gvayoy-web/proyecto-domus/hardware/Conexion_Domus_Guia_Completa.html

# DOMUS v5 - Guia de Conexiones Completa

Para la feria de ciencias - Todo paso a paso, sin experiencia previa requerida

## 1. COMPONENTES NECESARIOS

Tenemos: 2 protoboards, 1 fuente 5V/2A, ESP32-S3 N16R8, cables, componentes listados en nota 74.

# | Componente | Cantidad | Para que sirve | Protoboard

1 | ESP32-S3 N16R8 | 1 | Cerebro del sistema | Protoboard 1 (logica)
2 | LCD1602 + I2C backpack | 1 | Pantalla 16x2 caracteres | Protoboard 1
3 | DFPlayer Mini | 1 | Reproductor MP3 (voz Jarvis) | Protoboard 2 (cargas)
4 | Parlante 4ohm 3W | 1 | Audio principal | Protoboard 2
5 | Parlante 8ohm 1W | 1 | Audio serie (opcional) | Protoboard 2
6 | VS1838B receptor IR | 1 | Recibe mando remoto | Protoboard 1
7 | Mando IR 21 teclas | 1 | Control remoto | Mano del usuario
8 | DHT11 | 1 | Temperatura y humedad aire | Protoboard 1
9 | Sensor suelo resistivo | 1 | Humedad de la tierra | Protoboard 2
10 | Sensor nivel agua | 1 | Nivel del deposito | Protoboard 2
11 | LDR | 1 | Sensor de luz ambiental | Protoboard 1
12 | Mini bomba DC 3-6V | 1 | Riego automatico | Protoboard 2
13 | S8050 transistor NPN | 2 | Switch para bomba y LED VIVO | Protoboard 2 / 1
14 | LED sala + LED ducha | 2 | Luces de casa (paralelo) | Protoboard 2
15 | LED porche | 1 | luz exterior | Protoboard 2
16 | LED cultivo (x3) | 3 | Luces de invernadero | Protoboard 2
17 | LED VIVO azul | 1 | Indicador breathing | Protoboard 1
18 | Boton PARO | 1 | Emergencia fisica | Protoboard 1
19 | 1N4007 diodo | 1 | Proteccion bomba (flyback) | Protoboard 2
20 | Fuente 5V/2A USB-C | 1 | Alimenta bomba + LEDs + DFPlayer | Protoboard 2
21 | microSD 4-32GB | 1 | Almacena audios Jarvis | Dentro del DFPlayer

## 2. RESISTENCIAS NECESARIAS

Valor | Cantidad | Para que | Donde
330 ohm | 2 | Limitar corriente LED sala+ducha y LED porche | Protoboard 2
100 ohm | 1 | Limitar corriente 3xLED cultivo paralelo | Protoboard 2
1k ohm | 2 | Base S8050 (bomba + LED VIVO) | Protoboard 2 y 1
10k ohm | 3 | Pull-up DHT11, divisor LDR, bias S8050 | Protoboard 1

## 3. DISTRIBUCION EN PROTOBOARDS

GND COMUN: Ambos protoboards deben estar conectados por un cable GND. La tierra es la misma para todo.

PROTOBOARD 1 - LOGICA (alimentada por USB del ESP32)

Aqui van todos los componentes de señal y logica. Se alimentan del USB del ESP32 (3.3V y 5V del pin).

- ESP32-S3 - El cerebro, montado aqui
- LCD1602 I2C - SDA→GPIO17, SCL→GPIO13
- VS1838B IR - DATA→GPIO12
- DHT11 - DATA→GPIO14 + pull-up 10k
- LDR - Señal→GPIO3 + divisor 10k
- LED VIVO azul - Via S8050 → GPIO9
- Boton PARO - → GPIO10 → GND

PROTOBOARD 2 - CARGAS (alimentada por 5V/2A)

Aqui van todos los actuadores que consumen corriente. Se alimentan de la fuente externa 5V/2A.

- Bomba DC - Via S8050 → GPIO4 (senal desde Proto 1)
- LED sala + ducha - Paralelo → GPIO5 (senal)
- LED porche - → GPIO8 (senal)
- 3xLED cultivo - Paralelo → GPIO7 (senal)
- DFPlayer Mini - RX→GPIO11, TX→GPIO18 (senal)
- Sensor suelo - AO→GPIO15 (senal)
- Sensor nivel - S→GPIO16 (senal)

Los cables de senal (GPIO) van del Proto 2 al Proto 1. Usa cables largos de colores para no perderlos. Cada cable GPIO necesita un cable GND comun.

## 4. MAPA GPIO DEFINITIVO

GPIO | Funcion | Componente | Tipo | Protoboard | Color cable
3 | LDR | Fotoresistor + divisor 10k | Entrada analogica | 1 | Morado
4 | Bomba | S8050 base → colector bomba | Salida | 2 | Rojo
5 | Casa | 2 LEDs paralelo + 330ohm | Salida | 2 | Amarillo
7 | Cultivo | 3 LEDs paralelo + 100ohm | Salida | 2 | Azul
8 | Porche | 1 LED + 330ohm | Salida | 2 | Verde
9 | Jarvis VIVO | LED azul via S8050 | Salida PWM | 1 | Blanco
10 | PARO | Boton → GND | Entrada Pull-up | 1 | Gris
11 | ESP32 TX→DFPlayer RX | ESP32 envia comandos al DFPlayer | Salida | 2 | Naranja
12 | IR | VS1838B DATA | Entrada | 1 | Amarillo oscuro
13 | LCD SCL | I2C clock | Bidireccional | 1 | Azul claro
14 | DHT11 | DATA + pull-up 10k | Entrada | 1 | Naranja
15 | Suelo | Sensor resistivo AO | Entrada analogica | 2 | Marron
16 | Nivel | Sensor analogico S | Entrada analogica | 2 | Gris oscuro
17 | LCD SDA | I2C data | Bidireccional | 1 | Verde
18 | ESP32 RX←DFPlayer TX | ESP32 recibe datos del DFPlayer | Entrada | 2 | Morado

## 5. DIAGRAMA DE CONEXIONES

### Protoboard 1 - Logica

┌─────────────────────────────────────────────────────────────────────┐ │ PROTOBOARD 1 - LOGICA │ │ (Alimentada por USB ESP32) │ │ │ │ ┌──────────────────────────────────────────┐ │ │ │ ESP32-S3 N16R8 │ │ │ │ │ │ │ │ GPIO3 ──────── LDR (via 10k divider) │←── SEÑAL │ │ │ GPIO4 ──────── → Proto 2 (bomba) │←── SEÑAL │ │ │ GPIO5 ──────── → Proto 2 (casa LEDs) │←── SEÑAL │ │ │ GPIO7 ──────── → Proto 2 (cultivo) │←── SEÑAL │ │ │ GPIO8 ──────── → Proto 2 (porche) │←── SEÑAL │ │ │ GPIO9 ──────── LED VIVO (S8050) │←── SEÑAL │ │ │ GPIO10 ──────── Botón PARO → GND │←── GND │ │ │ GPIO11 ──────── RX ← DFPlayer TX │←── SEÑAL │ │ │ GPIO12 ──────── VS1838B DATA │←── SEÑAL │ │ │ GPIO13 ──────── LCD SCL │←── SEÑAL │ │ │ GPIO14 ──────── DHT11 DATA + 10k pull │←── SEÑAL │ │ │ GPIO15 ──────── → Proto 2 (suelo AO) │←── SEÑAL │ │ │ GPIO16 ──────── → Proto 2 (nivel S) │←── SEÑAL │ │ │ GPIO17 ──────── LCD SDA │←── SEÑAL │ │ │ GPIO18 ──────── TX → DFPlayer RX │←── SEÑAL │ │ │ │ │ │ │ 3V3 ──────── DHT11 VCC, LCD VCC, pull-ups │ │ │ GND ──────── GND comun (→ Proto 2 GND) │←── GND │ │ └──────────────────────────────────────────┘ │ │ │ │ ┌─────────────────┐ ┌─────────────────┐ ┌─────────────────┐ │ │ │ LCD1602 I2C │ │ VS1838B IR │ │ DHT11 │ │ │ │ SDA→GPIO17 │ │ DATA→GPIO12 │ │ DATA→GPIO14 │ │ │ │ SCL→GPIO13 │ │ VCC→3V3 │ │ VCC→3V3 │ │ │ │ VCC→5V (USB) │ │ GND→GND │ │ GND→GND │ │ │ │ GND→GND │ └─────────────────┘ └─────────────────┘ │ │ └─────────────────┘ │ │ ┌─────────────────┐ ┌─────────────────┐ │ │ │ LDR + 10k │ │ Botón PARO │ │ │ │ 1 terminal→3V3 │ │ 1 pin→GPIO10 │ │ │ │ 1 terminal→GPIO3│ │ 1 pin→GND │ │ │ │ 1 terminal→GND │ │ (usa INPUT_PULLUP)│ │ │ └─────────────────┘ └─────────────────┘ │ │ │ │ ┌─────────────────────────────────────────┐ │ │ │ LED VIVO azul + S8050 │ │ │ │ Base → 1k → GPIO9 │ │ │ │ Colector → LED → 330ohm → 5V (USB) │ │ │ │ Emisor → GND │ │ │ └─────────────────────────────────────────┘ │ │ │ │ ═══════════════════════════════════════════════════════════════ │ │ CABLE GND GRUESO → Proto 2 GND (OBLIGATORIO) │ │ CABLES GPIO × 8 → Proto 2 (señales de control) │ └─────────────────────────────────────────────────────────────────────┘

### Protoboard 2 - Cargas

┌─────────────────────────────────────────────────────────────────────┐ │ PROTOBOARD 2 - CARGAS │ │ (Alimentada por Fuente 5V/2A) │ │ │ │ ═══ 5V/2A ═══ ═══ GND ═══ │ │ │ │ ┌─────────────────────────────────────────┐ │ │ │ BOMBA DC 3-6V + S8050 + 1N4007 │ │ │ │ │ │ │ │ GPIO4(Proto1) → 1k → Base S8050 │←── SEÑAL GPIO4 │ │ │ Emisor S8050 → GND │ │ │ │ Colector S8050 → Bomba (-) │ │ │ │ Bomba (+) → 5V/2A │ │ │ │ 1N4007 diodo en paralelo con bomba │ │ │ │ (cátodo→Bomba+, ánodo→Bomba-) │ │ │ └─────────────────────────────────────────┘ │ │ │ │ ┌─────────────────────────────────────────┐ │ │ │ LED SALA + LED DUCHA (paralelo) │ │ │ │ │ │ │ │ GPIO5(Proto1) → 330ohm → (Anodo LED1 │←── SEÑAL GPIO5 │ │ │ + Anodo LED2) │ │ │ │ Cathodo LED1 + Cathodo LED2 → GND │ │ │ └─────────────────────────────────────────┘ │ │ │ │ ┌─────────────────────────────────────────┐ │ │ │ LED PORCHE │ │ │ │ │ │ │ │ GPIO8(Proto1) → 330ohm → Anodo LED │←── SEÑAL GPIO8 │ │ │ Cathodo LED → GND │ │ │ └─────────────────────────────────────────┘ │ │ │ │ ┌─────────────────────────────────────────┐ │ │ │ 3x LED CULTIVO (paralelo) │ │ │ │ │ │ │ │ GPIO7(Proto1) → 100ohm → (Anodo LED1 │←── SEÑAL GPIO7 │ │ │ + Anodo LED2 │ │ │ │ + Anodo LED3) │ │ │ │ Cathodos → GND │ │ │ └─────────────────────────────────────────┘ │ │ │ │ ┌─────────────────────────────────────────┐ │ │ │ DFPLAYER MINI │ │ │ │ │ │ │ │ VCC → 5V/2A │ │ │ │ GND → GND │ │ │ │ RX ← GPIO18(Proto1) TX ← ESP32 envia │←── SEÑAL GPIO18 │ │ │ TX → GPIO11(Proto1) RX → ESP32 recibe │←── SEÑAL GPIO11 │ │ │ BUSY → (opcional, no conectado) │ │ │ │ SPK_1 → Parlante 4ohm → SPK_2 │ │ │ │ ADKEY_1 → (no conectado) │ │ │ └─────────────────────────────────────────┘ │ │ │ │ ┌─────────────────────────────────────────┐ │ │ │ SENSOR SUELO RESISTIVO │ │ │ │ VCC → 5V/2A │ │ │ │ GND → GND │ │ │ │ AO → GPIO15(Proto1) ← SEÑAL │←── SEÑAL GPIO15 │ │ └─────────────────────────────────────────┘ │ │ │ │ ┌─────────────────────────────────────────┐ │ │ │ SENSOR NIVEL AGUA │ │ │ │ VCC → 5V/2A │ │ │ │ GND → GND │ │ │ │ S → GPIO16(Proto1) ← SEÑAL │←── SEÑAL GPIO16 │ │ └─────────────────────────────────────────┘ │ │ │ │ ═══════════════════════════════════════════════════════════════ │ │ CABLE GND GRUESO ← Proto 1 GND (OBLIGATORIO) │ │ CABLES GPIO × 8 ← Proto 1 (señales de control) │ └─────────────────────────────────────────────────────────────────────┘

## 6. PASOS DE CONEXION (sin experiencia)

### Fase 1: Protoboard 1 - Logica (30 minutos)

1 Montar ESP32 en protoboard
Inserta el ESP32-S3 N16R8 en el protoboard, cruzando la ranura central. Los pines del lado izquierdo (GPIO 3-18) son los que usaremos.

2 Conectar LCD1602 I2C
El LCD tiene 4 pines: VCC, GND, SDA, SCL.

Pin LCD | Conectar a | Color
VCC | 5V del ESP32 (pin 5V) | Rojo
GND | GND del ESP32 | Negro
SDA | GPIO17 del ESP32 | Verde
SCL | GPIO13 del ESP32 | Azul

El LCD I2C tiene una resistencia que dice "I2C" o "PCF8574". Asegurate de que el address sea 0x27 (el más común).

ALGUNOS backpacks I2C tienen pull-ups de SDA/SCL hacia 5V. El ESP32-S3 usa logica de 3.3V. Si el backpack tiene pull-ups a 5V, necesitas un divisor de voltaje en SDA y SCL (1k + 2k) para bajar a 3.3V. La mayoria de backpacks baratos funcionan bien directo porque las lineas I2C son open-drain y el voltaje lo define el pull-up.

3 Conectar receptor IR VS1838B
El VS1838B tiene 3 patas: OUT, GND, VCC.

Pin VS1838B | Conectar a | Color
OUT | GPIO12 del ESP32 | Amarillo
GND | GND del ESP32 | Negro
VCC | 3V3 del ESP32 | Rojo

El receptor IR tiene una malla metalica. Apuntalo hacia el mando a 1-2 metros de distancia.

4 Conectar DHT11
El DHT11 tiene 4 patas (mirandolo de frente, de izq a der): VCC, DATA, NC, GND.

Pin DHT11 | Conectar a | Color
VCC (pin 1) | 3V3 del ESP32 | Rojo
DATA (pin 2) | GPIO14 + resistor 10k a 3V3 | Naranja
NC (pin 3) | No conectar | -
GND (pin 4) | GND del ESP32 | Negro

El resistor de pull-up de 10k entre DATA y 3V3 es OBLIGATORIO. Sin él, el DHT11 no responde.

5 Conectar LDR (sensor de luz)
El LDR se conecta en divisor de voltaje:
3V3 ──→ LDR ──→ GPIO3 ──→ 10k ──→ GND

Conexión | Donde
3V3 → 1 terminal del LDR | Protoboard
Otro terminal del LDR → GPIO3 | Protoboard
GPIO3 → resistor 10k → GND | Protoboard

El LDR cambia de resistencia segun la luz. En oscuridad ~100kohm, en luz solar ~1kohm.

6 Conectar LED VIVO (breathing)
LED azul via transistor S8050:
GPIO9 → 1k → Base S8050
Colector S8050 → LED → 330ohm → 5V (USB)
Emisor S8050 → GND

7 Conectar boton PARO
Un pin del boton → GPIO10, otro pin → GND.

El firmware usa INPUT_PULLUP, asi que NO necesitas resistor externo. Solo conecta el boton entre GPIO10 y GND.

8 Conectar cables GPIO al Proto 2
Estos 8 cables van del Proto 1 al Proto 2 (largo ~30-50cm):

GPIO | Para que | Color sugerido
GPIO4 | Bomba (senal) | Rojo
GPIO5 | Casa LEDs (senal) | Amarillo
GPIO7 | Cultivo LEDs (senal) | Azul
GPIO8 | Porche LED (senal) | Verde
GPIO11 | DFPlayer RX (senal) | Naranja
GPIO15 | Sensor suelo (senal) | Marron
GPIO16 | Sensor nivel (senal) | Gris
GPIO18 | DFPlayer TX (senal) | Morado

9 Cable GND comun
CRITICO: Conecta un cable grueso del GND del Proto 1 al GND del Proto 2. Sin esto, nada funciona.

### Fase 2: Protoboard 2 - Cargas (45 minutos)

10 Alimentacion 5V/2A
Conecta la fuente USB-C 5V/2A a las rieles del protoboard: rojo a 5V, negro a GND.

11 Conectar bomba DC + S8050
GPIO4(Proto1) → 1k → Base S8050
Emisor S8050 → GND
Colector S8050 → Bomba(-)
Bomba(+) → 5V/2A
1N4007 diodo: cátodo→Bomba(+), ánodo→Bomba(-)

El diodo 1N4007 es OBLIGATORIO. Sin él, el motor de la bomba puede dañar el transistor al apagarse (fenómeno de retroEMF).

12 Conectar LEDs de casa (sala+ducha)
GPIO5(Proto1) → 330ohm → Anodo LED sala + Anodo LED ducha
Cathodo LED sala + Cathodo LED ducha → GND
Los dos LEDs van en paralelo, compartiendo la misma resistencia.

13 Conectar LED porche
GPIO8(Proto1) → 330ohm → Anodo LED porche
Cathodo LED porche → GND

14 Conectar 3x LED cultivo
GPIO7(Proto1) → 100ohm → (Anodo LED1 + Anodo LED2 + Anodo LED3)
Cathodo LED1 + Cathodo LED2 + Cathodo LED3 → GND
Los 3 LEDs van en paralelo. La resistencia es menor (100ohm) porque hay 3 LEDs compartiendo.

15 Conectar DFPlayer Mini

Pin DFPlayer | Conectar a | Color
VCC | 5V/2A | Rojo
GND | GND | Negro
RX | GPIO18(Proto1) TX ← ESP32 envia | Morado
TX | GPIO11(Proto1) RX ← ESP32 recibe | Naranja
SPK_1 | Parlante 4ohm | Parlante
SPK_2 | Parlante 4ohm | Parlante

CRUZADOS: DFPlayer RX ← ESP32 TX (GPIO18), DFPlayer TX → ESP32 RX (GPIO11). RX del DFPlayer recibe del TX del ESP32.

16 Conectar sensor suelo

Pin Sensor | Conectar a
VCC | 5V/2A
GND | GND
AO | GPIO15(Proto1)

17 Conectar sensor nivel agua

Pin Sensor | Conectar a
VCC | 5V/2A
GND | GND
S | GPIO16(Proto1)

18 Insertar microSD en DFPlayer
La microSD debe estar formateada FAT32, 4-32GB. Los audios van en carpetas 01-21 y 51-71.

## 7. ALIMENTACION DUAL

┌─────────────────────────────────────────────────────────────────────┐ │ ALIMENTACION DUAL │ │ │ │ ┌──────────────┐ ┌──────────────┐ │ │ │ USB-C │ │ 5V/2A │ │ │ │ ESP32 │ │ USB-C │ │ │ └──────┬───────┘ └──────┬───────┘ │ │ │ │ │ │ ▼ ▼ │ │ ┌──────────────┐ ┌──────────────┐ │ │ │ PROTO 1 │ │ PROTO 2 │ │ │ │ Logica │ │ Cargas │ │ │ │ │ │ │ │ │ │ • ESP32 │ │ • Bomba │ │ │ │ • LCD │ │ • LEDs │ │ │ │ • Sensores │ │ • DFPlayer │ │ │ │ • IR │ │ • Sensores │ │ │ │ • PARO │ │ │ │ │ └──────┬───────┘ └──────┬───────┘ │ │ │ │ │ │ └──────────┬─────────────┘ │ │ │ │ │ ═══ GND COMUN ═══ │ │ (cable grueso obligatorio) │ │ │ │ Consumo estimado: │ │ • Bomba: 0.5-0.6A (pico al arrancar) │ │ • DFPlayer: 0.2A │ │ • LEDs: 0.1A total │ │ • ESP32 + sensores: 0.15A │ │ ───────────────────── │ │ Total max: ~1.05A ← La fuente 2A sobra con margen │ └─────────────────────────────────────────────────────────────────────┘

Por que dual?
• El ESP32 se alimenta por USB (su propio cable USB del ordenador)
• Las cargas (bomba, LEDs, DFPlayer) se alimentan de la fuente externa 5V/2A
• GND comun es OBLIGATORIO para que las señales GPIO funcionen

## 8. FUNCIONES DEL FIRMWARE

Funcion | Que hace | Cuando se ejecuta
ejecutarModoInteligente() | Coordina riego, luces, limites diarios | Cada 5s en loop()
verificarRiegoAutomatico() | Enciende bomba si suelo seco | Cada 5s
verificarRiegoAutomaticoCombinado() | Riego con temp + humedad | Cada 5s
verificarLucesCombinadas() | Luces por LDR + PIR + hora | Cada 5s
verificarLimiteBomba() | Apaga bomba a los 5 min continuos | Cada ciclo
verificarAutomacionesRelativas() | Timeout manual bomba/luces | Cada ciclo
diagnosticarSensores() | Lee 7 sensores, muestra en LCD, audio | Tecla EQ
ejecutarTeclaIRCasa() | Procesa cada tecla del mando IR | Al recibir IR
revisarControlesFisicos() | Boton PARO fisico | Cada ciclo
revisarComandosSerial() | Comandos USB para debug | Cada ciclo
refrescarPantallaFinal() | Actualiza LCD con estado | Cada 500ms
demoSecuenciaActualizar() | Secuencia demo luces | Si esta activa

## 9. MAPA TECLAS IR

Tecla | Funcion | Audio Jarvis | Variante
CH- | Modo manual (todos OFF auto) | "Entendido" | 1-4 aleatoria
CH | Pantalla siguiente | "Orden confirmada" | 1-4 aleatoria
CH+ | Modo automatico | "Ejecutando" | 1-4 aleatoria
ANTERIOR | Casa ON/OFF | "Iluminacion activada/desactivada" | 1=ON, 2=OFF
PLAY | Silencio audio ON/OFF | Confirmacion | ON/OFF
SIGUIENTE | Porche ON/OFF | "Porche iluminado/apagado" | 1=ON, 2=OFF
VOL- | Bajar volumen | Feedback | 1-4
VOL+ | Subir volumen | Feedback | 1-4
EQ | Diagnostico robusto | Segun resultado (OK/FAIL/TODO FAIL) | 1-2 OK, 3-4 FAIL
0 | Todo apagado | "Todas las salidas detenidas" | 1-2
100+ | Cambiar voz Carlos/Karla | "Sistemas en linea" | 1=Carlos, 2=Karla
200+ | Rearme seguro | "Rearme logrado/bloqueado" | 1-2 OK, 3-4 FAIL
1 | Casa ON/OFF | "Iluminacion activada/desactivada" | 1=ON, 2=OFF
2 | Porche ON/OFF | "Porche iluminado/apagado" | 1=ON, 2=OFF
3 | Cultivo ON/OFF | "Luces de cultivo activadas/off" | 1=ON, 2=OFF
4 | Todas las luces ON/OFF | "Iluminacion activada/desactivada" | 1=ON, 2=OFF
5 | Riego ON/OFF | "Iniciando riego/Riego detenido" | 1=ON, 2=OFF
6 | Temperatura (consulta) | "Temperatura elevada" | 1-2
7 | Humedad (consulta) | "Humedad adecuada" | 1-4
8 | Suelo + deposito (consulta) | "La tierra esta seca/humeda" | 1-2
9 | Estado completo | "Estado completo reportado" | 1-4

Voces: Carlos (carpetas 01-21) y Karla (carpetas 51-71). Cada carpeta tiene 4 variantes (pistas 001-004). La tecla 100+ alterna entre voces.

## 10. MODO INTELIGENTE - COMO FUNCIONA

Condicion | Accion | Limite | Audio
Tierra seca + agua OK | Bomba ON | 30 min/dia, cooldown 5 min | "Iniciando riego"
Agua baja | Bomba OFF (interlock) | Siempre | "Riego detenido"
Oscuridad + presencia | Casa ON | Sin limite (PIR controla) | "Iluminacion activada"
Sin presencia | Casa OFF (ahorro) | Sin limite | "Iluminacion desactivada"
Oscuridad (cualquier cosa) | Cultivo ON (fotoperiodo) | 16 horas/dia | "Luces de cultivo activadas"
Luz >= 40% + presencia reciente | Casa OFF | Sin limite | "Iluminacion desactivada"
DHT11 fallo > 5 min | Alerta (no apaga nada) | 1 alerta/min | -
Limite bomba alcanzado | Bomba OFF | 30 min/dia | "Riego detenido"
Limite cultivo alcanzado | Cultivo OFF | 16 h/dia | "Cultivo off"

El modo inteligente NO reemplaza el control manual. Si prendes una luz con el mando, el modo inteligente la respeta y no la apaga.

## 11. DIAGNOSTICO ROBUSTO (tecla EQ)

Cuando presionas EQ, el sistema:

1. Lee el DHT11 → muestra temperatura en LCD → audio "Temperatura..."
2. Lee el sensor de suelo → muestra % humedad → audio "Tierra seca/humeda"
3. Lee el sensor de nivel → muestra crudo → audio "Agua..."
4. Lee el LDR → muestra % luz → audio "Luz..."
5. PIR → sin hardware fisico, siempre OK (presencia constante)
6. Verifica bomba (GPIO) → audio "Bomba..."
7. Verifica LCD (I2C) → audio "Display..."
8. Calcula OK/FAIL total → audio final: todos OK / algunos FAIL / todos FAIL

Audio segun resultado:
• Todos OK → "Todos los sensores OK" (carpeta 9, voz 1-2)
• Algunos FAIL → "Sensor sin respuesta" (carpeta 18, voz 3-4)
• Todos FAIL → "Sistema bloqueado" (carpeta 12, voz 3-4)

## 12. TROUBLESHOOTING

Problema | Causa probable | Solucion
LCD no muestra nada | Falla I2C, address incorrecto | Verificar cables SDA/SCL, probar address 0x27 o 0x3F
DHT11 siempre NaN | Falta pull-up 10k | Conectar resistor 10k entre DATA y 3V3
IR no responde | Receptor mal conectado o sin power | Verificar VCC=3V3, GND, DATA→GPIO12
Bomba no arranca | S8050 mal conectado, falta diodo | Verificar base→GPIO4 via 1k, colector→bomba
DFPlayer no suena | RX/TX cruzados, SD no formateada | Verificar RX↔TX cruzados, formatear SD FAT32
LEDs no encienden | Resistencia incorrecta, polaridad invertida | Verificar anodo→resistencia→GPIO, cathodo→GND
Sensores dan valores raros | GND no comun entre protoboards | Conectar cable GND grueso entre protoboards
ESP32 se reinicia | Bomba causa pico de corriente | Usar fuente separada para bomba, cable GND grueso

## 13. CHECKLIST PRE-ENCENDIDO

✓ GND comun conectado entre ambos protoboards

✓ Alimentacion dual: USB ESP32 + Fuente 5V/2A en protoboard 2

✓ Resistencias correctas: 330ohm (LEDs), 100ohm (cultivo), 1k (S8050), 10k (DHT11, LDR)

✓ Diodo 1N4007 en paralelo con bomba (cátodo a +)

✓ DFPlayer RX/TX cruzados (RX→TX, TX→RX)

✓ MicroSD formateada FAT32 con carpetas 01-21 y 51-71

✓ S8050 orientacion correcta: mirando la cara plana, de izq a der: Collector, Base, Emitter

✓ LEDs polaridad correcta: anodo (+) mas largo, cathodo (-) mas corto

✓ Cables GPIO identificados por color entre protoboards
