gvayoy-web/proyecto-domus/hardware/planos/diagrama_conexiones.html

# 🏠 DOMUS Perfil 4 — Diagrama de Conexiones Completo

✅ Firmware subido a COM9 · ESP32-S3 N16R8 · Perfil 4 · 2026-09-18

## 1. Esquema de Conexiones Eléctricas (SVG)

## 2. Tabla Maestra de Pines del ESP32-S3

# | GPIO | Función Principal | Tipo | Módulo | Estado

1 | GPIO3 | LDR Fotoresistor (divisor 3V3/R=10k) | ADC | Sensor luz | ✅ Activo
2 | GPIO4 | DRV8833 AIN1 (bomba) + UART1 RX (DFPlayer) | OUTUART | Bomba + Audio | ✅ Activo
3 | GPIO5 | DRV8833 BIN1 (ventilador) | OUT | Ventilador | ✅ Activo
4 | GPIO6 | DRV8833 BIN2 (ventilador) | OUT | Ventilador | ✅ Activo
5 | GPIO7 | DRV8833 AIN2 (bomba) + UART1 TX (DFPlayer) | OUTUART | Bomba + Audio | ✅ Activo
6 | GPIO8 | 74HC595 DS (data shift) + Relé salidas | GPIO | Luces + Relés | ✅ Activo
7 | GPIO9 | PIR HC-SR501 (detección movimiento) | IN | Seguridad | ✅ Activo
8 | GPIO10 | Botón PARO emergencia (INPUT_PULLUP) | IN | Seguridad | ✅ Activo
9 | GPIO11 | 74HC595 SHCP (shift clock) — sacrifica botón SILENCIO | OUT | Luces | ✅ Activo
10 | GPIO12 | IR Receiver VS1838B (recepción 21 teclas) | IN | Control IR | ✅ Activo
11 | GPIO13 | LCD 1602 I2C SCL | I2C | Pantalla | ✅ Activo
12 | GPIO14 | DHT11 DATA (temp/humedad ambiental) | IN | Sensor clima | ✅ Activo
13 | GPIO15 | Sensor humedad suelo (ADC1) | ADC | Riego | ✅ Activo
14 | GPIO16 | Sensor nivel agua tanque (ADC1) | ADC | Riego | ✅ Activo
15 | GPIO17 | LCD 1602 I2C SDA | I2C | Pantalla | ✅ Activo
16 | GPIO18 | 74HC595 STCP (storage clock) — sacrifica botón MODO | OUT | Luces | ✅ Activo

## 3. DRV8833 — Driver Dual H-Bridge (Motores)

ESP32 | DRV8833 | Función | Lógica
GPIO4 | AIN1 | Bomba — Canal A Entrada 1 | HIGH → forward
GPIO7 | AIN2 | Bomba — Canal A Entrada 2 | HIGH → reverse
GPIO5 | BIN1 | Ventilador — Canal B Entrada 1 | HIGH → forward
GPIO6 | BIN2 | Ventilador — Canal B Entrada 2 | HIGH → reverse
3V3 | nSLEEP | Habilitación del driver | → VCC (HIGH)
GND | GND | Tierra común | Compartida

🪫 Alimentación motores: Fuente externa 5V/2A → pin Vms del DRV8833. GND de la fuente → GND del ESP32 (tierra común obligatoria). El DRV8833 consume hasta 1.8A/A (bomba + ventilador en simultáneo).

⚠️ Pin compartido: GPIO4 y GPIO7 están dualmente asignados a DRV8833 y UART1 (DFPlayer). El DRV8833 escribe directamente en GPIO. El DFPlayer solo usa UART. No usar GPIO4/GPIO7 como salidas digitales adicionales.

## 4. 74HC595 — Shift Register para 3 LEDs

ESP32 | 74HC595 | Pin | Función
GPIO8 | DS | 14 | Datos serie entrada
GPIO11 | SH_CP | 11 | Reloj de desplazamiento
GPIO18 | ST_CP | 12 | Reloj de almacenamiento
3V3 | OE | 13 | Habilitado (LOW = activo)
3V3 | MR | 10 | Reset (HIGH)
GND | GND | 8 | Tierra
VCC | Q0-Q7 | 1-7,15 | 8 salidas paralelo

💡 Salidas: Q0→LED Luz Sala · Q1→LED Luz Cuarto · Q2→LED Luz Cultivo. Cada LED con resistencia limitadora 220Ω-470Ω. Los pines SHCP (GPIO11) y STCP (GPIO18) sacrifican los botones físicos SILENCIO y MODO. Secuencia: shift 8 bits → latch → salidas actualizadas.

## 5. DFPlayer Mini — Reproductor MP3 por UART1

ESP32 | DFPlayer | Función | Nota
GPIO4 (UART1 RX) | TX | Datos ESP32 → DFPlayer | Compartido con DRV8833 AIN1
GPIO7 (UART1 TX) | RX | Datos DFPlayer → ESP32 | Compartido con DRV8833 AIN2
5V | VCC | Alimentación | Desde fuente 5V/2A
GND | GND | Tierra común | Compartida
— | SPK1/SPK2 | Salida altavoz | Parlante 4Ω/3W
— | BUSY | Detección reproducción | Conectado a GPIO (-1 si no usa)

🔊 Especificaciones: 168 archivos MP3 (1 por tecla IR) en carpeta /mp3 de MicroSD. Puerto: transporteDFPlayer.begin(4, 7, MP3_BUSY_PIN). Baud rate: 9600. Audio actualmente APLAZADO — espera módulo MAX98306 compatible.

⚠️ Audio APLAZADO: El firmware tiene el audio deshabilitado por defecto. Se necesita un altavoz compatible MAX98306 y los 168 archivos MP3. El código está preparado (domus_dfplayer.h, domus_jarvis_audio.h) pero sin activar.

## 6. Sensor DHT11 — Temperatura/Humedad Ambiental

ESP32 | DHT11 | Tipo | Nota
GPIO14 | DATA | Digital IN | + R=4.7k pull-up a VCC
3V3 | VCC | Alimentación | 3.3V
GND | GND | Tierra | —

🌡️ Especificaciones: Rango: 0-50°C · Humedad: 20-90%HR · Precisión: ±2°C, ±5%HR · Actualización: ~1 lectura/segundo. DISTINTO del sensor de humedad de suelo (GPIO15). El DHT11 mide el aire alrededor de la maceta, no la tierra. Backoff: reintento cada 60s si suspendido.

## 7. LCD 1602 con Módulo I2C (PCF8574)

ESP32 | LCD I2C | Tipo | Nota
GPIO13 | SCL | I2C Clock | Reloj I2C
GPIO17 | SDA | I2C Data | Datos I2C
3V3 | VCC | Alimentación | Dirección 0x27 o 0x3F
GND | GND | Tierra | —

📺 Pantalla: LCD 16×2 caracteres con módulo backlight PCF8574. Dirección I2C: 0x27 (más común) o 0x3F. Se detecta automáticamente en setup(). Librería: LiquidCrystal_I2C. Muestra configuración, estado y valores de sensores.

## 8. LDR + PIR + IR + Botón PARO

ESP32 | Dispositivo | Tipo | Especificación
GPIO3 | LDR Fotoresistor | Divisor | 3V3 → R=10k → GPIO3 → LDR → GND. Calibrado como LUZ_PCT (0-100%)
GPIO9 | PIR HC-SR501 | Digital IN | Alcance ~7m, ángulo ~120°, tiempo de detección ~5s
GPIO10 | Botón PARO | INPUT_PULLUP | LOW = paro emergencia activo. Con resistencia pull-up interna
GPIO12 | IR Receiver VS1838B | Digital IN | Protocolo NEC. 21 teclas mapeadas. Rango ~3-5m

## 9. Sensores de Suelo y Nivel de Agua

ESP32 | Sensor | Tipo | Calibración | Uso
GPIO15 | Sensor humedad suelo | ADC1 (12-bit) | Seco=2800, Húmedo=1200 | HUM_PCT (0-100%) · Riego automático
GPIO16 | Sensor nivel agua | ADC1 (12-bit) | 0-4095 rango | VerificarLimiteBomba() · Nivel tanque

## 10. Flujo de Control del Firmware

┌─────────────────────────────────────────────────────────────────┐
│                    FUENTES DE COMANDO                           │
│  IR Remote · Serial USB · Botón PARO · Automatismo local        │
└──────────────────────────┬──────────────────────────────────────┘
                           ▼
┌─────────────────────────────────────────────────────────────────┐
│                    DESPACHADOR (revisarControlesFisicos)         │
│                                                                 │
│  ┌─────────────┐  ┌──────────────┐  ┌──────────────────────┐   │
│  │ Seguridad   │  │ MODO_SEGURO  │  │ DRIVER_MOTORES_LISTO │   │
│  │ EMERGENCIA  │  │ Validación   │  │ F1 acreditada +      │   │
│  │ → PARO      │  │ Perfil 4     │  │ PERFIL_CON_DRV8833  │   │
│  └─────────────┘  └──────────────┘  └──────────────────────┘   │
└──────────────────────────┬──────────────────────────────────────┘
                           ▼
┌─────────────────────────────────────────────────────────────────┐
│                  ejecutarOrdenActuador()                        │
│                                                                 │
│  if (salida_no_instalada) → NACK                                │
│  if (driver_no_listo) → NACK                                    │
│  if (DRIVER_MOTORES_LISTO) → driverMotoresAplicarFinal()       │
└──────────────────────────┬──────────────────────────────────────┘
                           ▼
┌─────────────────────────────────────────────────────────────────┐
│                  SALIDAS FÍSICAS                                  │
│                                                                 │
│  DRV8833:  Bomba (GPIO4/7) · Ventilador (GPIO5/6)               │
│  74HC595:  LED Sala (Q0) · LED Cuarto (Q1) · LED Cultivo (Q2)   │
│  Relés:    Salida lógica GPIO8 (HIGH activo)                    │
└──────────────────────────┬──────────────────────────────────────┘
                           ▼
┌─────────────────────────────────────────────────────────────────┐
│                  TELEMETRÍA SENSORES (SENSORES;)                │
│                                                                 │
│  ┌────────────────┐ ┌────────────────┐ ┌──────────────────┐   │
│  │ HUM_PCT        │ │ TEMP_C         │ │ LUZ_PCT          │   │
│  │ Suelo (GPIO15) │ │ Aire (GPIO14) │ │ LDR (GPIO3)     │   │
│  └────────────────┘ └────────────────┘ └──────────────────┘   │
│  ┌────────────────┐ ┌────────────────┐                        │
│  │ NIVEL_AGUA     │ │ EMERGENCIA     │                        │
│  │ (GPIO16)       │ │ · MODO_SEGURO  │                        │
│  └────────────────┘ └────────────────┘                        │
└─────────────────────────────────────────────────────────────────┘

## 11. Distribución de Alimentación

Componente | Voltaje | Corriente | Fuente | Nota
ESP32-S3 | 3.3V | ~240mA | USB CH343 | Consumo base
DRV8833 (Vms) | 5V | Hasta 2A | Fuente 5V/2A | Bomba + ventilador
DFPlayer Mini | 5V | ~100mA | Fuente 5V/2A | MP3 + altavoz
LCD 1602 I2C | 5V | ~100mA | Fuente 5V/2A | Con backlight
Relés (×2) | 3.3V | ~40mA | ESP32 GPIO | Salida lógica
74HC595 | 3.3V | ~20mA | ESP32 GPIO | Shift register
Sensores (×6) | 3.3V | ~1-20mA | ESP32 GPIO VCC | LDR, PIR, DHT11, IR, suelo, nivel
LEDs (×3) | 3.3V | ~20mA | 74HC595 Q0-Q2 | Con resistencias 220Ω

⚠️ TIERRA COMÚN OBLIGATORIA: El GND del ESP32, el GND de la fuente 5V/2A, y el GND de TODOS los módulos deben estar conectados al MISMO punto de referencia. Una tierra flotante causa lecturas erráticas de ADC y comportamiento inestable del DRV8833.

## 12. Estado Actual del Sistema

Aspecto | Valor | Estado
Compilación | 422,873 bytes flash (32%) | ✅
RAM | 28,904 bytes (8%) | ✅
Subida | COM9 · ESP32-S3 QFN56 | ✅
Perfil | CASA_FINAL_DRV8833_DFPLAYER | ✅
Tests | 106/106 pasando | ✅
F1 Validación | DOMUS_DRIVER_VALIDADO=0 | ⚠️
Audio DFPlayer | APLAZADO | ⏳
HIL test_05 | Fallas comando LUZ1_ON | ⏳

✅ RESUMEN: Firmware perfil 4 completamente compilado y subido al ESP32-S3 en COM9. DRV8833, 74HC595, y DFPlayer configurados en el código. Motores y luces funcionales una vez validada la puerta F1 (verificación física del módulo DRV8833). Audio pendiente de recepción del altavoz MAX98306 y los 168 archivos MP3.

DOMUS Proyecto de Feria de Ciencias — Isaac · Perfil 4 CASA_FINAL_DRV8833_DFPLAYER · Documento generado 2026-09-18
