gvayoy-web/proyecto-domus/obsidian/proyect domus/75 - Audio Jarvis remodelado - Carlos Karla y SD.md

---
estado: vigente
fecha: 2026-09-21
autoridad: 75
tipo: audio-jarvis-remodelado
reemplaza: 65, 67
---

# 75 - Audio Jarvis remodelado - Carlos, Karla y SD

> [!IMPORTANT]
> Esta nota reemplaza las notas 65 y 67 como referencia de audio.
> Actualizada con 21 eventos (no 14), 168 MP3 (no 56/112), y estructura
> de SD corregida.

## Decision final

Jaravis habla con pistas MP3 pregrabadas en la microSD del DFPlayer Mini.
Dos voces: Carlos (carpetas 01-21) y Karla (carpetas 51-71). El mando IR
envia ordenes al ESP32; el ESP32 decide, aplica protecciones, y despues
solicita la frase al DFPlayer. El reproductor nunca controla bomba ni
seguridad.

**No hay IA ni reconocimiento de voz.** Jarvis es la personalidad de las
respuestas locales.

## Estructura de la microSD

`
microSD FAT32/
├── 01/  001.mp3  002.mp3  003.mp3  004.mp3   ← Sistema listo
├── 02/  001-004                            ← Orden aceptada
├── 03/  001-004                            ← Orden rechazada
├── 04/  001-004                            ← Casa encendida
├── 05/  001-004                            ← Casa apagada
├── 06/  001-004                            ← Porche encendido
├── 07/  001-004                            ← Porche apagado
├── 08/  001-004                            ← Cultivo encendido
├── 09/  001-004                            ← Cultivo apagado
├── 10/  001-004                            ← Riego iniciado
├── 11/  001-004                            ← Riego detenido
├── 12/  001-004                            ← Tierra seca
├── 13/  001-004                            ← Tierra humeda
├── 14/  001-004                            ← Agua baja
├── 15/  001-004                            ← Emergencia
├── 16/  001-004                            ← Error sensor
├── 17/  001-004                            ← Presencia
├── 18/  001-004                            ← Temperatura alta
├── 19/  001-004                            ← Riego auto
├── 20/  001-004                            ← Diagnostico
├── 21/  001-004                            ← Estado completo
├── 51/  001-004                            ← (Karla) Sistema listo
├── 52/  001-004                            ← (Karla) Orden aceptada
├── ...                                     ← mismos eventos +50
└── 71/  001-004                            ← (Karla) Estado completo
`

**Total: 21 eventos x 4 variantes x 2 voces = 168 MP3**

## Catalogo de eventos

| Carpeta | Evento | Variante 1 | Variante 2 | Variante 3 | Variante 4 |
|---|---|---|---|---|---|
| 01 | Sistema listo | Sistemas en linea | DOMUS operativo | Inicializacion completa | Casa preparada |
| 02 | Orden aceptada | Entendido | Orden confirmada | Ejecutando instruccion | Como ordene |
| 03 | Orden rechazada | Orden no permitida | No puedo ejecutar eso | Solicitud bloqueada | Accion denegada |
| 04 | Casa encendida | Iluminacion activada | Luz encendida | He iluminado el area | Circuito activo |
| 05 | Casa apagada | Iluminacion desactivada | Luz apagada | Area en oscuro | Circuito detenido |
| 06 | Porche encendido | Porche iluminado | Luz exterior activada | Entrada iluminada | Exterior activo |
| 07 | Porche apagado | Porche apagado | Luz exterior off | Exterior en oscuro | Entrada apagada |
| 08 | Cultivo encendido | Luces de cultivo activadas | Invernadero iluminado | Fotosintesis activa | Cultivo listo |
| 09 | Cultivo apagado | Luces de cultivo off | Invernadero apagado | Fotosintesis pausada | Cultivo off |
| 10 | Riego iniciado | Iniciando riego | Bomba activada | Regando el cultivo | Ciclo de riego |
| 11 | Riego detenido | Riego detenido | Bomba desactivada | Ciclo finalizado | He detenido el riego |
| 12 | Tierra seca | La tierra esta seca | Humedad baja | El cultivo necesita agua | Suelo seco |
| 13 | Tierra humeda | Humedad adecuada | La tierra esta humeda | Suelo nivel OK | Suficiente humedad |
| 14 | Agua baja | Nivel de agua bajo | Deposito insuficiente | Riego bloqueado | Recargue el deposito |
| 15 | Emergencia | Emergencia activada | Todas las salidas detenidas | Sistema bloqueado | Paro activo |
| 16 | Error sensor | Sensor sin respuesta | Lectura no valida | Revise conexiones | Diagnostico requerido |
| 17 | Presencia | Presencia detectada | Movimiento registrado | Hay actividad | Sensor activado |
| 18 | Temp alta | Temperatura elevada | Ambiente caliente | Recomiendo ventilacion | Umbral termico |
| 19 | Riego auto | Riego automatico activado | Auto-riego en marcha | Sensor bajo, regando | Ciclo automatico |
| 20 | Diagnostico | Todos los sensores OK | Diagnostico completo | Sistema saludable | Verificacion exitosa |
| 21 | Estado | Estado completo reportado | Resumen del sistema | Informe de estado | Todo en orden |

## Como generar los MP3

Usar 	ools/generate_jarvis_audio.py con edge-tts:

`ash
python tools/generate_jarvis_audio.py --voz es-HN-CarlosNeural --salida audio/Carlos
python tools/generate_jarvis_audio.py --voz es-HN-KarlaNeural --salida audio/Karla
`

Luego copiar a SD:
- udio/Carlos/01..21/ → 1..21/ en la SD
- udio/Karla/01..21/ → 51..71/ en la SD (cada carpeta +50)

## Mapeo de teclas IR a eventos Jarvis

| Tecla IR | Evento Jarvis | Carpeta Carlos | Carpeta Karla |
|---|---|---|---|
| CH- (0x45) | CH_MENOS | 01 | 51 |
| CH (0x46) | CH | 02 | 52 |
| CH+ (0x47) | CH_MAS | 03 | 53 |
| ANTERIOR (0x44) | ANTERIOR | 04 | 54 |
| PLAY (0x43) | PLAY | 05 | 55 |
| SIGUIENTE (0x40) | SIGUIENTE | 06 | 56 |
| VOL- (0x07) | VOL_MENOS | 07 | 57 |
| VOL+ (0x15) | VOL_MAS | 08 | 58 |
| EQ (0x09) | EQ | 09 | 59 |
| 0 (0x16) | TECLA_0 | 10 | 60 |
| 100+ (0x19) | TECLA_100 | 11 | 61 |
| 200+ (0x0D) | TECLA_200 | 12 | 62 |
| 1 (0x0C) | TECLA_1 | 13 | 63 |
| 2 (0x18) | TECLA_2 | 14 | 64 |
| 3 (0x5E) | TECLA_3 | 15 | 65 |
| 4 (0x08) | TECLA_4 | 16 | 66 |
| 5 (0x1C) | TECLA_5 | 17 | 67 |
| 6 (0x5A) | TECLA_6 | 18 | 68 |
| 7 (0x42) | TECLA_7 | 19 | 69 |
| 8 (0x52) | TECLA_8 | 20 | 70 |
| 9 (0x4A) | TECLA_9 | 21 | 71 |

## Reglas de audio

1. **Cada tecla IR tiene audio** - toda accion genera una frase Jarvis
2. **Sin repeticion inmediata** - si repite la misma tecla, usa variante diferente
3. **Emergencia interrumpe** - PARO (tecla 0 variantes 3-4) para cualquier reproduccion
4. **Cooldown alertas** - 30s entre alertas automaticas del mismo tipo
5. **Prioridad**: emergencia > manual > automatica
6. **Modo silencio** - PLAY alterna silencio ON/OFF (solo audio, no LCD ni seguridad)

## Configuracion

- UART: 9600 baudios, GPIO11 (RX) / GPIO18 (TX)
- Volumen inicial: 18/30
- EQ: normal (no bass)
- BUSY: no conectado (-1)
- Parlantes: serie, VOL <= 20

## Notas obsoletas que esta nota reemplaza

- [[65 - Arquitectura de audios Jarvis con DFPlayer]] → obsoleta (14 eventos, 56 MP3)
- [[67 - Estado Jarvis dos voces y pendientes reales]] → obsoleta (112 pistas)

## Relacionadas

- [[74 - Hardware final y mapa GPIO v5]]
- [[76 - Control IR y modo inteligente]]
- [[00 - Inicio]]
