gvayoy-web/proyecto-domus/output/modelo_3d_fixed.png

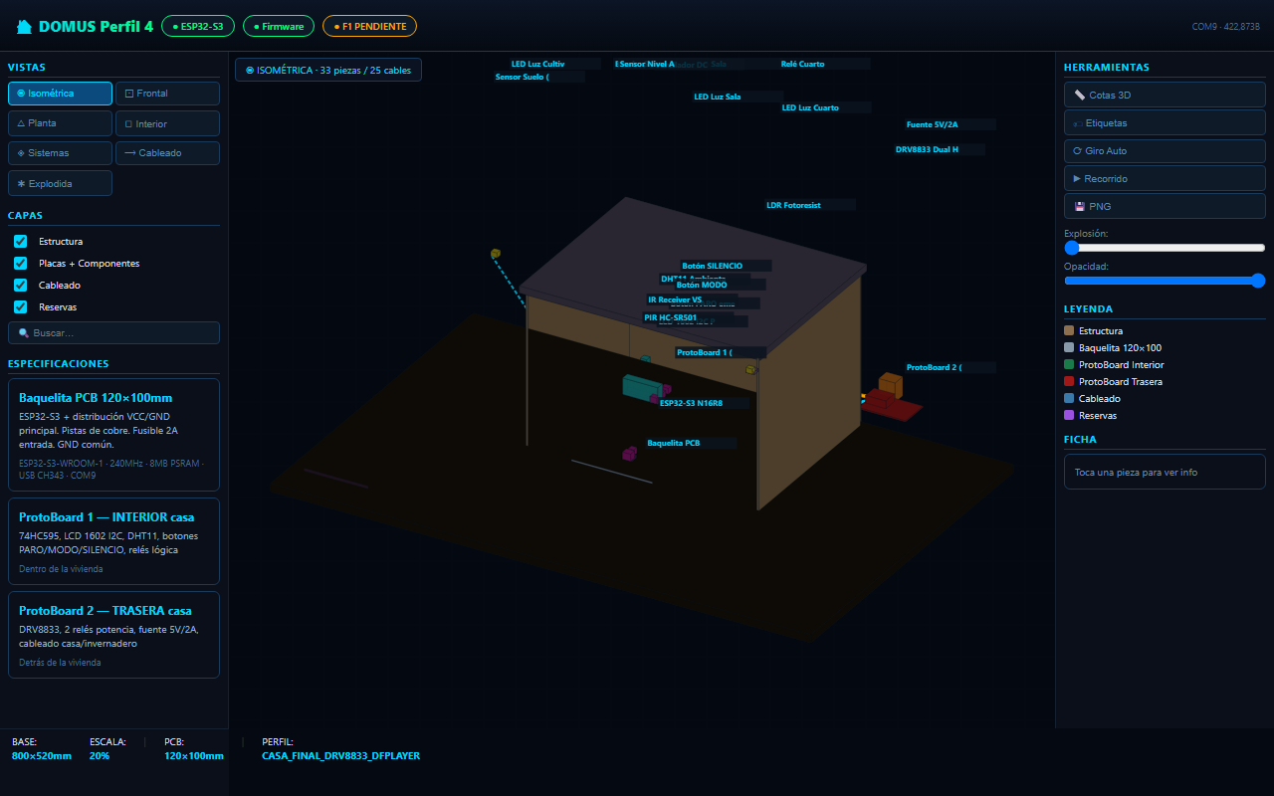
output/modelo_3d_fixed.png
