gvayoy-web/proyecto-domus/firmware/casa_inteligente_v4/domus_jarvis_audio.h

#pragma once
#include <Arduino.h>
#include "domus_dfplayer.h"

// Habilitación de audio: depende del perfil CASA_FINAL_DRV8833_DFPLAYER
// y de que DOMUS_DRIVER_VALIDADO=1 (puerta F1).
#ifndef AUDIO_CANDIDATO_HABILITADO
// Fallback: verificar si el perfil es el final con DRV8833 validado
#define AUDIO_CANDIDATO_HABILITADO (DOMUS_PERFIL_CASA == 4 && DOMUS_DRIVER_VALIDADO == 1)
#endif

// Catálogo Jarvis: 21 botones del mando CAR MP3 + evento FALLO (22).
// Cada botón vive en su carpeta: voz 1 (Carlos) 01-21, voz 2 (Karla) 51-71
// (desplazamiento +50). FALLO = carpeta 22/72 ("No funciono."). Códigos
// físicos capturados en la nota Obsidian 64 (protocolo P7); acciones por
// botón en la nota 46; DFPlayer exige carpetas 01-99 con pistas 001-004
// (nota 65).
//
// Convención de variantes (001-004) por carpeta:
// - Conmutadores (casa, porche, spare/CH, todas_luces, riego):
//   1 = ON manual, 2 = OFF manual, 3 = ON automático, 4 = OFF automático.
// - Botón 0: 1-2 = apagado general; 3-4 = PARO de emergencia.
// - EQ: 1-2 = diagnóstico manual; 3-4 = fallo de sensor (automático).
// - Tecla 3 (cultivo sin hardware): las 4 = "No funciono."
// - Tecla 8 (suelo): 1-2 = consulta; 3 = tierra seca; 4 = depósito bajo
//   (reservada; sin sonda de nivel en el inventario).
// - Tecla 9 (estado): las 4 = estado general; la 3 = "Sistemas en línea"
//   (arranque y confirmación de cambio de voz).
// - Tecla 200+: 1-2 = rearme logrado; 3-4 = sigue bloqueado.
// - Tecla 100+: 1/3 = voz Carlos, 2/4 = voz Karla (un toque alterna;
//   repetir quedó solo en Serial).
// - Resto (CH-, CH+, Play, VOL-, VOL+, 6, 7): 4 variantes del mismo
//   significado; Play usa paridad ON {1,3} / OFF {2,4}.
// - FALLO (22): las 4 = "No funciono." (orden rechazada o GPIO sin etapa).
enum class EventoJarvis : uint8_t {
  CH_MENOS = 1,    // CH- 0x45: modo manual
  CH = 2,          // CH  0x46: spare ON/OFF (LCD descartado, nota 80)
  CH_MAS = 3,      // CH+ 0x47: modo automático
  ANTERIOR = 4,    // Anterior 0x44: luz de sala (comparte con tecla 1)
  PLAY = 5,        // Play 0x43: silencio on/off
  SIGUIENTE = 6,   // Siguiente 0x40: luz de cuarto (comparte con tecla 2)
  VOL_MENOS = 7,   // VOL- 0x07: bajar volumen
  VOL_MAS = 8,     // VOL+ 0x15: subir volumen
  EQ = 9,          // EQ 0x09: diagnóstico
  TECLA_0 = 10,    // 0 0x16: todo apagado (+ PARO físico)
  TECLA_100 = 11,  // 100+ 0x19: alterna voz Carlos/Karla (un toque)
  TECLA_200 = 12,  // 200+ 0x0D: rearme seguro
  TECLA_1 = 13,    // 1 0x0C: luz de sala → Casa
  TECLA_2 = 14,    // 2 0x18: luz de cuarto → Porche
  TECLA_3 = 15,    // 3 0x5E: sin luz de cultivo en el hardware
  TECLA_4 = 16,    // 4 0x08: todas las luces ON/OFF
  TECLA_5 = 17,    // 5 0x1C: riego
  TECLA_6 = 18,    // 6 0x5A: consulta temperatura
  TECLA_7 = 19,    // 7 0x42: consulta humedad
  TECLA_8 = 20,    // 8 0x52: consulta suelo
  TECLA_9 = 21,    // 9 0x4A: estado completo (+ arranque)
  FALLO = 22,      // orden rechazada / sin etapa: "No funciono."

  // Aliases semánticos para clarity en el código de automatización
  CASA_ENCENDIDA = TECLA_1,       // Carpeta 13: "Iluminación activada"
  CASA_APAGADA = TECLA_1,         // Carpeta 13: "Luz apagada"
  PORCHE_ENCENDIDO = TECLA_2,     // Carpeta 14: "Porche iluminado"
  PORCHE_APAGADO = TECLA_2,       // Carpeta 14: "Porche apagado"
  TODAS_LUCES_ON = TECLA_4,       // Carpeta 16: "Todas las luces on"
  TODAS_LUCES_OFF = TECLA_4,      // Carpeta 16: "Todas las luces off"
  RIEGO_INICIADO = TECLA_5,       // Carpeta 17: "Iniciando riego"
  RIEGO_DETENIDO = TECLA_5,       // Carpeta 17: "Riego detenido"
  TIERRA_SECA = TECLA_8,          // Carpeta 20: "La tierra está seca"
  AGUA_BAJA = FALLO,              // sin sonda: cualquier fallo de orden
  DIAG_TODOS_OK = EQ,             // Carpeta 9: "Diagnóstico completo"
  DIAG_ALGUNOS_FAIL = TECLA_6,    // Carpeta 18: "Sensor sin respuesta"
  DIAG_TODOS_FAIL = TECLA_200,    // Carpeta 12: "Sistema bloqueado"
  SISTEMA_LISTO = TECLA_9,        // Carpeta 21: "Sistemas en línea"
};

// Política no bloqueante de Jarvis: variantes sin repetición inmediata.
// Las alertas automáticas usan enfriamiento de 30 s; el PARO interrumpe
// cualquier frase y siempre tiene prioridad.
class JarvisAudio {
 public:
  static constexpr uint8_t NUM_EVENTOS = 22;
  static constexpr uint8_t DESPLAZAMIENTO_VOZ_2 = 50;

  explicit JarvisAudio(DFPlayerTransport& transporte) : transporte_(transporte) {}

  void begin(uint8_t volumenInicial = 18) {
    volumen_ = volumenInicial > 30 ? 30 : volumenInicial;
    habilitado_ = transporte_.listo() && transporte_.volumen(volumen_);
  }

  bool habilitado() const { return habilitado_; }
  bool silenciado() const { return silenciado_; }
  // true mientras el DFPlayer reproduce (solo si el perfil conectó BUSY).
  bool ocupado() const { return transporte_.ocupado(); }
  uint8_t volumenActual() const { return volumen_; }
  uint8_t vozActual() const { return voz_; }
  void silenciar(bool valor) { silenciado_ = valor; if (valor) transporte_.detener(); }

  bool cambiarVoz() {
    voz_ = voz_ == 1 ? 2 : 1;
    return habilitado_;
  }

  bool ajustarVolumen(int8_t delta) {
    int nuevo = int(volumen_) + delta;
    if (nuevo < 0) nuevo = 0;
    if (nuevo > 30) nuevo = 30;
    volumen_ = uint8_t(nuevo);
    return habilitado_ && transporte_.volumen(volumen_);
  }

  // Carpeta DFPlayer para un evento y voz dados. Voz 1: 01-22, voz 2: 51-72.
  static uint8_t carpetaPara(EventoJarvis evento, uint8_t voz) {
    const uint8_t base = static_cast<uint8_t>(evento);
    if (base < 1 || base > NUM_EVENTOS) return 0;
    return voz == 2 ? uint8_t(base + DESPLAZAMIENTO_VOZ_2) : base;
  }

  // variante: 0 = aleatoria 1-4; 1-4 = pista fija (p. ej. 1 = ON, 2 = OFF).
  bool reproducir(EventoJarvis evento, uint32_t ahoraMs,
                  bool alertaAutomatica = false, uint8_t variante = 0) {
    const uint8_t eventoBase = static_cast<uint8_t>(evento);
    if (!habilitado_ || silenciado_ || eventoBase < 1 || eventoBase > NUM_EVENTOS)
      return false;
    if (variante > 4) return false;
    const uint8_t carpeta = carpetaPara(evento, voz_);
    const bool emergencia = evento == EventoJarvis::TECLA_0 && variante >= 3;
    if (!emergencia && transporte_.ocupado()) return false;
    if (alertaAutomatica && !emergencia &&
        ahoraMs - ultimoEventoMs_[eventoBase] < ENFRIAMIENTO_ALERTA_MS) return false;
    if (emergencia) transporte_.detener();

    uint8_t pista;
    if (variante != 0) {
      pista = variante;
    } else {
      pista = 1 + uint8_t(esp_random() % 4U);
      if (pista == ultimaPista_[eventoBase]) pista = uint8_t((pista % 4U) + 1U);
    }
    if (!transporte_.reproducirCarpeta(carpeta, pista)) return false;
    ultimaPista_[eventoBase] = pista;
    ultimoEventoMs_[eventoBase] = ahoraMs;
    ultimoEvento_ = evento;
    ultimaCarpetaReproducida_ = carpeta;
    ultimaPistaReproducida_ = pista;
    return true;
  }

  // Aleatoria entre dos variantes (p. ej. grupo(1,2) = par ON/OFF manual),
  // evitando repetir la misma pista dos veces seguidas.
  bool reproducirGrupo(EventoJarvis evento, uint32_t ahoraMs,
                       bool alertaAutomatica, uint8_t vA, uint8_t vB) {
    if (vA < 1 || vA > 4 || vB < 1 || vB > 4 || vA == vB) return false;
    const uint8_t eventoBase = static_cast<uint8_t>(evento);
    const uint8_t elegida =
        (ultimaPista_[eventoBase] == vA) ? vB
        : (ultimaPista_[eventoBase] == vB) ? vA
        : (esp_random() % 2U == 0 ? vA : vB);
    return reproducir(evento, ahoraMs, alertaAutomatica, elegida);
  }

  // Conmutador con alternas: ON rota {1,3}, OFF rota {2,4} (carpeta Play).
  bool reproducirEstado(EventoJarvis evento, uint32_t ahoraMs,
                        bool alertaAutomatica, bool encendido) {
    const uint8_t eventoBase = static_cast<uint8_t>(evento);
    if (eventoBase < 1 || eventoBase > NUM_EVENTOS) return false;
    const uint8_t base = encendido ? 1 : 2;
    const uint8_t alt = uint8_t(base + 2U);
    const uint8_t elegida = (ultimaPista_[eventoBase] == base) ? alt : base;
    return reproducir(evento, ahoraMs, alertaAutomatica, elegida);
  }

  bool repetirUltima(uint32_t ahoraMs) {
    (void)ahoraMs;
    if (!habilitado_ || silenciado_ || transporte_.ocupado() ||
        ultimaCarpetaReproducida_ == 0 || ultimaPistaReproducida_ == 0) return false;
    return transporte_.reproducirCarpeta(ultimaCarpetaReproducida_,
                                         ultimaPistaReproducida_);
  }

 private:
  static constexpr uint32_t ENFRIAMIENTO_ALERTA_MS = 30000UL;
  DFPlayerTransport& transporte_;
  uint32_t ultimoEventoMs_[NUM_EVENTOS + 1] = {};
  uint8_t ultimaPista_[NUM_EVENTOS + 1] = {};
  EventoJarvis ultimoEvento_ = EventoJarvis::CH_MENOS;
  uint8_t ultimaCarpetaReproducida_ = 0;
  uint8_t ultimaPistaReproducida_ = 0;
  uint8_t volumen_ = 18;
  uint8_t voz_ = 1;
  bool habilitado_ = false;
  bool silenciado_ = false;
};
