gvayoy-web/proyecto-domus/firmware/tests/test_pantalla_final.py

"""Pruebas de la pantalla final LCD1602 I2C (rama task/lcd-final).

Verifica el header real domus_pantalla.h compilandolo con g++ mediante
fakes minimos de Arduino/LiquidCrystal_I2C (patron del repo: sin
compilador se reporta skipTest explicito) y revisa por texto que el
header no use pausas bloqueantes y que el borrado total este acotado.
"""

import shutil
import tempfile
import unittest
from pathlib import Path
import sys, os
sys.path.insert(0, os.path.dirname(os.path.abspath(__file__)))
from test_native_firmware import run_host_process


ROOT = Path(__file__).resolve().parents[2]
SKETCH_DIR = ROOT / "firmware" / "casa_inteligente_v4"
HEADER = SKETCH_DIR / "domus_pantalla.h"
SKETCH = SKETCH_DIR / "casa_inteligente_v4.ino"

FAKE_ARDUINO_H = """\
#pragma once
#include <stdint.h>
#include <cstdio>
#include <cstring>
#include <cmath>
unsigned long millis();
"""

FAKE_LCD_H = """\
#pragma once
#include <stdint.h>
#include <stddef.h>
#include <string.h>
class LiquidCrystal_I2C {
 public:
  LiquidCrystal_I2C(uint8_t d, uint8_t c, uint8_t f)
      : direccion(d), columnas(c), filas(f), cursorC(0), cursorR(0),
        escrituras(0), iconos(0) {
    limpiarCeldas();
  }
  void init() {}
  void backlight() {}
  void clear() {
    ++barridos;
    limpiarCeldas();
    cursorC = 0;
    cursorR = 0;
  }
  void setCursor(uint8_t c, uint8_t r) {
    ++movimientosCursor;
    cursorC = c;
    cursorR = r;
  }
  size_t print(char ch) {
    ++escrituras;
    if (cursorR < 2 && cursorC < 16) celdas[cursorR][cursorC] = ch;
    ++cursorC;
    return 1;
  }
  void createChar(uint8_t, uint8_t[]) { ++iconos; }
  static int barridos;
  static int movimientosCursor;
  int escrituras;
  int iconos;
  char celdas[2][16];

 private:
  void limpiarCeldas() {
    for (int f = 0; f < 2; ++f)
      for (int c = 0; c < 16; ++c) celdas[f][c] = ' ';
  }
  uint8_t direccion, columnas, filas, cursorC, cursorR;
};
int LiquidCrystal_I2C::barridos = 0;
int LiquidCrystal_I2C::movimientosCursor = 0;
"""

HARNESS_CPP = """\
#include <cstdio>
#include <cstring>
#include "domus_pantalla.h"

static unsigned long g_ahora = 0;
unsigned long millis() { return g_ahora; }

static int fallos = 0;
#define CHEQUEA(cond) \\
  do { \\
    if (!(cond)) { ++fallos; std::printf("FALLO:%d\\n", __LINE__); } \\
  } while (0)

static DatosPantallaFinal datosBase() {
  DatosPantallaFinal d;
  d.tempC = 25.0f; d.tempValida = true;
  d.humAire = 60.0f; d.humAireValida = true;
    d.sueloPct = 45; d.sueloValido = true;
  // Sin sonda de depósito: nivel inválido siempre; vista 1 solo suelo.
  d.nivelRaw = 0; d.nivelPct = 0; d.nivelValido = false; d.nivelMin = 600;
  d.luzPct = 70; d.luzValida = true;
  d.presencia = true;
  for (int i = 0; i < 5; ++i) d.salidas[i] = SAL_OFF;
  d.emergencia = false; d.modoSeguro = false; d.error = "";
  d.escuchando = false; d.micOn = true;
  d.statEncendidos = 12; d.statApagados = 10; d.statRiegos = 3;
  d.statVent = 2; d.statCambiosLuz = 7; d.statEmergencias = 1;
  d.nombrePerfil = "BANCO_COMPLETO_S8050_IR";
  d.nombreBomba = "S8050"; d.nombreAudioIR = "IR ON";
  return d;
}

int main() {
  {
    int base = fallos;
    PantallaFinal p;
    p.begin(nullptr);
    DatosPantallaFinal d = datosBase();
    char l0[17], l1[17];
    for (uint8_t v = 0; v < 7; ++v) {
      p.formatear(v, d, l0, l1);
      CHEQUEA(std::strlen(l0) == 16 && std::strlen(l1) == 16);
    }
    p.formatear(5, d, l0, l1);
    CHEQUEA(std::strstr(l0, "ENC:012 APA:010") != nullptr);
    CHEQUEA(std::strstr(l1, "R:03 V:02 E:01") != nullptr);
    p.formatear(3, d, l0, l1);
    CHEQUEA(std::strstr(l0, "B:0 Ca:0 P:0") != nullptr);
    CHEQUEA(std::strlen(l0) == 16 && std::strlen(l1) == 16);
    p.formatear(6, d, l0, l1);
    CHEQUEA(std::strstr(l0, "PERFIL:") != nullptr);
    CHEQUEA(std::strstr(l1, "S8050") != nullptr);
    p.formatear(2, d, l0, l1);
    CHEQUEA(l1[12] == ' ' && l1[15] == ' ');
    char largo[41];
    for (int i = 0; i < 40; ++i) largo[i] = (char)('A' + (i % 26));
    largo[40] = '\\0';
    d.error = largo;
    p.formatear(4, d, l0, l1);
    CHEQUEA(std::strlen(l1) == 16 && std::memcmp(l1, largo, 16) == 0);
    for (int i = 0; i < 5; ++i) d.salidas[i] = SAL_AUTO;
    d.error = "";
    p.formatear(3, d, l0, l1);
    CHEQUEA(std::strlen(l0) == 16 && std::strlen(l1) == 16);
    if (fallos == base) std::puts("FMT_OK");
  }
  {
    int base = fallos;
    PantallaFinal p;
    p.begin(nullptr);
    DatosPantallaFinal d = datosBase();
    p.irA(1);
    d.emergencia = true;
    CHEQUEA(p.efectiva(d) == 4);
    d.emergencia = false;
    d.modoSeguro = true;
    CHEQUEA(p.efectiva(d) == 4);
    d.modoSeguro = false;
    d.error = "FALLO X";
    CHEQUEA(p.efectiva(d) == 4);
    d.error = "";
    p.irA(2);
    CHEQUEA(p.efectiva(d) == 2);
    g_ahora = 5000;
    d.emergencia = true;
    p.tick(d);
    CHEQUEA(std::strstr(p.linea(0), "EMERGENCIA") != nullptr);
    if (fallos == base) std::puts("PRIO_OK");
  }
  {
    int base = fallos;
    PantallaFinal p;
    p.begin(nullptr);
    DatosPantallaFinal d = datosBase();
    d.tempValida = false;
    d.humAireValida = false;
    d.sueloValido = false;
    d.luzValida = false;
    char l0[17], l1[17];
    p.formatear(0, d, l0, l1);
    CHEQUEA(std::strstr(l0, "ERR") && std::strstr(l1, "ERR"));
    p.formatear(1, d, l0, l1);
    CHEQUEA(std::strstr(l0, "ERR") != nullptr);
    CHEQUEA(std::strstr(l1, "Sin deposito") != nullptr);
    p.formatear(2, d, l0, l1);
    CHEQUEA(std::strstr(l0, "ERR") != nullptr);
    d = datosBase();
    p.formatear(0, d, l0, l1);
    CHEQUEA(std::strstr(l0, "25") && !std::strstr(l0, "ERR"));
    p.formatear(1, d, l0, l1);
    CHEQUEA(std::strstr(l0, "45") && !std::strstr(l0, "ERR"));
    CHEQUEA(std::strstr(l1, "Sin deposito") != nullptr);
    if (fallos == base) std::puts("ERR_OK");
  }
  {
    int base = fallos;
    LiquidCrystal_I2C lcd(0x27, 16, 2);
    PantallaFinal p;
    g_ahora = 0;
    LiquidCrystal_I2C::barridos = 0;
    LiquidCrystal_I2C::movimientosCursor = 0;
    p.begin(&lcd);
    CHEQUEA(LiquidCrystal_I2C::barridos == 1);
    DatosPantallaFinal d = datosBase();
    p.tick(d);
    CHEQUEA(std::strstr(p.linea(0), "PROJECT DOMUS") != nullptr);
    CHEQUEA(LiquidCrystal_I2C::barridos == 1);
    g_ahora = 5000;
    p.tick(d);
    CHEQUEA(LiquidCrystal_I2C::barridos == 1);
    int movs = LiquidCrystal_I2C::movimientosCursor;
    p.tick(d);
    CHEQUEA(LiquidCrystal_I2C::movimientosCursor == movs);
    p.siguiente();
    p.tick(d);
    CHEQUEA(p.indice() == 1);
    p.mostrarIR(7, 0x00FF, 0x0019);
    p.tick(d);
    CHEQUEA(std::strstr(p.linea(0), "P7 A00FF") != nullptr);
    CHEQUEA(std::strstr(p.linea(1), "0x0019") != nullptr);
    g_ahora = 10001;
    p.tick(d);
    CHEQUEA(std::strstr(p.linea(0), "Suelo") != nullptr);
    if (fallos == base) std::puts("TICK_OK");
  }
  {
    int base = fallos;
    PantallaFinal p;
    p.begin(nullptr);
    DatosPantallaFinal d = datosBase();
    g_ahora = 20000;
    p.tick(d);
    g_ahora = 23000;
    p.mostrarMensaje("Sala ON", "Mando IR");
    p.tick(d);
    CHEQUEA(std::strstr(p.linea(0), "Sala ON") != nullptr);
    CHEQUEA(std::strstr(p.linea(1), "Mando IR") != nullptr);
    p.ocultarOverlays();
    p.tick(d);
    CHEQUEA(std::strstr(p.linea(0), "Sala ON") == nullptr);
    g_ahora = 30000;
    p.mostrarIR(7, 0x00FF, 0x0019);
    p.ocultarOverlays();
    p.tick(d);
    CHEQUEA(std::strstr(p.linea(0), "P7 A00FF") == nullptr);
    if (fallos == base) std::puts("AVISO_OK");
  }
  return fallos == 0 ? 0 : 1;
}
"""


class PantallaFinalTests(unittest.TestCase):
    @classmethod
    def setUpClass(cls):
        cls.header = HEADER.read_text(encoding="utf-8")
        cls.sketch = SKETCH.read_text(encoding="utf-8")

    def test_header_tiene_formato_fijo_sombra_e_iconos(self):
        self.assertIn("%-16.16s", self.header)
        self.assertIn("[2][17]", self.header)
        self.assertIn("setCursor", self.header)
        self.assertIn("createChar", self.header)
        self.assertIn("PROJECT DOMUS", self.header)
        self.assertIn("class PantallaFinal", self.header)
        self.assertIn("NUM_PANTALLAS = 7", self.header)
        self.assertIn("P_EMERGENCIA = 4", self.header)
        # Vista 3 compacta de 1 letra con leyenda documentada.
        self.assertIn("Leyenda vista 3", self.header)
        self.assertIn("case SAL_ON: return '1'", self.header)
        self.assertIn("mostrarMensaje", self.header)
        self.assertIn("ocultarOverlays", self.header)

    def test_header_sin_pausas_y_borrado_acotado(self):
        self.assertNotIn("delay(", self.header)
        usos = self.header.count("clear()")
        self.assertGreaterEqual(usos, 1)
        self.assertLessEqual(usos, 2)
        for linea in self.header.splitlines():
            if "clear()" in linea:
                self.assertIn("lcd_->clear();", linea)

    def test_ino_delega_dibujo_en_la_clase(self):
        # Demo feria headless (LCD quemado): la clase se integra pero no hay
        # refresco ni navegación por botón MODO en el .ino.
        for fragmento in (
            '#include "domus_pantalla.h"',
            "PantallaFinal pantallaFinal;",
            "pantallaFinal.begin(lcd);",
            "escanearBusI2C",
            "INTERVALO_PANTALLA_MS",
            "ultimoCambioBotonDemoMs",
        ):
            self.assertIn(fragmento, self.sketch)
        for fragmento_ausente in (
            "refrescarPantallaFinal();",
            "pantallaFinal.tick(d);",
            "pantallaFinal.siguiente();",
            "clasificarSalidaFinal",
        ):
            self.assertNotIn(fragmento_ausente, self.sketch)
        for funcion_vieja in (
            "void mostrarBienvenida",
            "void actualizarPantallaEstado",
            "void mostrarPantallaError",
            "void mostrarEscuchando",
            "mostrarEscuchando()",
        ):
            self.assertNotIn(funcion_vieja, self.sketch)

    def test_modo_solo_navega_y_sensores_se_inicializan_antes_de_refrescar(self):
        controles = self.sketch.split("void revisarControlesFisicos()", 1)[1].split("\n}", 1)[0]
        self.assertNotIn("ejecutarOrdenActuador", controles)
        self.assertNotIn("BOTON_LUZ_SALA", controles)
        self.assertIn("MODO/LCD descartado", controles)

        setup = self.sketch.split("void setup()", 1)[1].split("\n}", 1)[0]
        self.assertIn("pantallaFinal.begin(lcd);", setup)
        self.assertIn("analogReadResolution(12);", setup)
        self.assertNotIn("dht.begin();", setup)
        self.assertNotIn("refrescarPantallaFinal();", setup)

    def test_nativo_formato_prioridad_err_y_diferencial(self):
        compiler = shutil.which("g++") or shutil.which("clang++")
        if not compiler:
            self.skipTest("No host C++ compiler; native LCD checks run on Ubuntu CI")
        with tempfile.TemporaryDirectory(prefix="domus-pantalla-") as directory:
            include = Path(directory) / "include"
            include.mkdir()
            (include / "Arduino.h").write_text(FAKE_ARDUINO_H, encoding="utf-8")
            (include / "LiquidCrystal_I2C.h").write_text(FAKE_LCD_H, encoding="utf-8")
            cpp = Path(directory) / "test.cpp"
            cpp.write_text(HARNESS_CPP, encoding="utf-8")
            binary = Path(directory) / "test.exe"
            compiled = run_host_process(
                [compiler, "-std=c++17", "-Wall", "-Wextra",
                 "-I", str(include), "-I", str(SKETCH_DIR),
                 str(cpp), "-o", str(binary)],
                timeout=60,
            )
            self.assertEqual(compiled.returncode, 0, compiled.stderr)
            result = run_host_process([str(binary)], timeout=10, allow_skip=True)
            self.assertEqual(result.returncode, 0, result.stdout)
            salida = result.stdout.decode()
            for token in ("FMT_OK", "PRIO_OK", "ERR_OK", "TICK_OK", "AVISO_OK"):
                self.assertIn(token, salida)


if __name__ == "__main__":
    unittest.main(verbosity=2)
