gvayoy-web/proyecto-domus/firmware/tests/test_firmware_contract.py

import unittest
from pathlib import Path


ROOT = Path(__file__).resolve().parents[2]
FIRMWARE = ROOT / "firmware" / "casa_inteligente_v4" / "casa_inteligente_v4.ino"
WORKFLOW = ROOT / ".github" / "workflows" / "firmware-ci.yml"


class FirmwareContractTests(unittest.TestCase):
    @classmethod
    def setUpClass(cls):
        cls.source = FIRMWARE.read_text(encoding="utf-8")
        cls.workflow = WORKFLOW.read_text(encoding="utf-8")

    def test_exactly_five_logical_outputs(self):
        self.assertRegex(self.source, r"#define\s+TOTAL_SALIDAS\s+5\b")
        self.assertNotRegex(self.source, r"PINES_SALIDAS\s*\[\s*8\s*\]")

    def test_relay_abstraction_is_gone(self):
        # Migración Fase E paso 1 (nota 46/52): cero restos de la abstracción de relés.
        for token in (
            "CANTIDAD_RELES", "PINES_RELES", "NOMBRES_RELES",
            "SALIDA_ACTIVA_EN_LOW", "RELE_ACTIVO_LOW", "RELE_ACTIVO_EN_LOW",
            "estadoReles", "propietarioReles",
            "encenderRele", "apagarRele",
            "verificarEstadoLogicoGpio", "fallosVerificacionRele",
            "USAR_DRV8833",
        ):
            self.assertNotIn(token, self.source)

    def test_arduino_prototypes_can_resolve_command_types(self):
        self.assertIn('#include "domus_types.h"', self.source)
        header = FIRMWARE.with_name("domus_types.h").read_text(encoding="utf-8")
        for declaration in ("enum OrigenOrden", "struct OrdenActuador", "struct ResultadoOrden"):
            self.assertIn(declaration, header)

    def test_serial_discards_entire_overlong_line_and_yields(self):
        serial = self.source.split("void revisarComandosSerial() {", 1)[1].split("void revisarControlesFisicos", 1)[0]
        self.assertIn("bytesProcesados < 128", serial)
        self.assertIn("descartarComandoHastaNuevaLinea = true", serial)
        self.assertIn("if (caracter == '\\n') descartarComandoHastaNuevaLinea = false", serial)
        self.assertLess(serial.index("if (descartarComandoHastaNuevaLinea)"), serial.index("procesarComandoTexto"))

    def test_adc_rails_are_rejected(self):
        import re
        for low, high in (("HUMEDAD_MIN_VALIDA", "HUMEDAD_MAX_VALIDA"),
                          ("LDR_MIN_VALIDO", "LDR_MAX_VALIDO")):
            minimum = int(re.search(r"#define\s+" + low + r"\s+(\d+)", self.source)[1])
            maximum = int(re.search(r"#define\s+" + high + r"\s+(\d+)", self.source)[1])
            self.assertTrue(0 < minimum < maximum < 4095)

    def test_economical_outputs_default_matches_mounted_wiring(self):
        # Cableado montado (nota 78): "+" de cada carga hacia el GPIO,
        # "-" a GND → variante económica activa en HIGH, default 1.
        self.assertIn("#define DOMUS_SALIDAS_ECONOMICAS 1", self.source)
        self.assertNotIn("RELE_ACTIVO_EN_LOW", self.source)
        self.assertIn("nivelSalida(indice, true)", self.source)
        self.assertIn("nivelSalida(indice, false)", self.source)

    def test_invalid_gpio22_and_fake_wind_sensor_do_not_return(self):
        self.assertNotIn("GPIO22", self.source)
        self.assertNotIn("PIN_VIENTO", self.source)
        self.assertNotIn("leerViento", self.source)

    def test_firmware_has_no_ble_or_network_dependency(self):
        self.assertNotIn("NimBLE", self.source)
        self.assertNotIn("WiFi.h", self.source)
        self.assertNotIn("NimBLE-Arduino", self.workflow)

    def test_lcd_is_the_only_display_dependency(self):
        self.assertIn("LiquidCrystal_I2C", self.source)
        self.assertNotIn("Adafruit_SSD1306", self.source)
        self.assertNotIn("PANTALLA_OLED", self.source)
        product_job = self.workflow.split("compilar-perfiles-alfa:", 1)[0]
        self.assertNotIn("Adafruit SSD1306", product_job)

    def test_pump_has_timeout_interlock_no_level_sensor(self):
        # Sin sonda de depósito en el inventario: solo timeout gobierna la bomba.
        self.assertNotIn("nivel_agua_bajo", self.source)
        self.assertNotIn("leerNivelAgua", self.source)
        self.assertIn("TIEMPO_MAXIMO_BOMBA_MS", self.source)
        self.assertIn("verificarLimiteBomba();", self.source)

    def test_automatic_controls_have_separate_hysteresis_thresholds(self):
        # Demo feria IR+luces: umbral de riego/ventilador se conserva como
        # contrato de calibración (static_assert) aunque el ciclo automático
        # esté fuera del firmware mínimo.
        self.assertRegex(
            self.source, r"#define\s+UMBRAL_HUMEDAD_SECA_PCT\s+35\b"
        )
        self.assertRegex(
            self.source, r"#define\s+UMBRAL_HUMEDAD_HUMEDA_PCT\s+45\b"
        )
        self.assertRegex(
            self.source, r"#define\s+UMBRAL_TEMP_ALTA_C\s+28\.0\b"
        )
        self.assertRegex(
            self.source, r"#define\s+UMBRAL_TEMP_NORMAL_C\s+26\.0\b"
        )
        self.assertIn(
            "static_assert(UMBRAL_HUMEDAD_SECA_PCT < UMBRAL_HUMEDAD_HUMEDA_PCT",
            self.source,
        )

    def test_emergency_stop_blocks_new_on_orders(self):
        self.assertIn("paroEmergenciaActivo && orden.encender", self.source)
        self.assertIn("activarParoEmergencia", self.source)
        self.assertIn("rearmarSistema", self.source)

    def test_health_supervisor_degrades_without_restart_loop(self):
        self.assertIn("MEMORIA_LIBRE_CRITICA_BYTES", self.source)
        self.assertIn("entrarModoSeguro(\"memoria_critica\")", self.source)
        self.assertIn("reiniciosCriticosConsecutivos >= 3", self.source)
        self.assertIn("modoSeguroActivo && orden.encender", self.source)
        self.assertIn("RECUPERAR", self.source)
        self.assertNotIn('esp_restart();', self.source)

    def test_no_speech_recognition_or_tinyml_runtime(self):
        for token in (
            "JARVIS_LOCAL_HABILITADO", "esp_afe_sr", "esp_mn_", "multinet",
            "modelo_mn", "MIC_WS_PIN", "TTS_BCLK_PIN",
        ):
            self.assertNotIn(token, self.source)
        self.assertIn("RECONOCIMIENTO_VOZ=NO_USADO", self.source)

    def test_serial_flood_is_limited_but_emergency_bypasses_limit(self):
        self.assertIn("MAX_COMANDOS_POR_SEGUNDO", self.source)
        self.assertIn('comando != "PARO" && !permitirComandoSerial()', self.source)
        self.assertIn("limite_de_frecuencia", self.source)

    def test_critical_sensor_failures_cut_automatic_outputs(self):
        # Demo IR+luces: sin ciclo automático de riego/luces combinadas no hay
        # motivo RIEGO_BLOQUEADO_SENSOR/LUCES_BLOQUEADAS en runtime; el ventilador
        # ya no existe.
        self.assertNotIn("VENT_BLOQUEADO_SENSOR", self.source)
        self.assertNotIn("verificarRiegoAutomatico", self.source)
        self.assertNotIn("verificarLucesCombinadas", self.source)

    def test_mic_off_and_physical_backup_are_present(self):
        self.assertIn("MAPA_CASA.micOff", self.source)
        self.assertIn("MAPA_CASA.demo", self.source)
        self.assertIn("revisarControlesFisicos();", self.source)

    def test_micro_sd_has_real_read_write_self_test(self):
        self.assertIn("SD.begin", self.source)
        self.assertIn("domus_selftest.txt", self.source)
        self.assertIn("PROJECT_DOMUS_SD_OK", self.source)

    def test_uninstalled_sd_stays_disabled(self):
        self.assertRegex(self.source, r"#define\s+MICROSD_HABILITADA\s+false\b")

    def test_compile_time_pin_registry_prevents_duplicates(self):
        self.assertIn("PINES_RESERVADOS_DOMUS", self.source)
        self.assertIn("constexpr bool pinesDomusSonUnicos()", self.source)
        self.assertIn(
            'static_assert(pinesDomusSonUnicos(), "Hay GPIO duplicados en el mapa DOMUS")',
            self.source,
        )

    def test_all_assigned_optional_buses_are_reserved(self):
        registry = self.source.split(
            "constexpr int PINES_RESERVADOS_DOMUS[] = {", 1
        )[1].split("};", 1)[0]
        for symbol in (
            "SD_SCK_PIN",
            "SD_MISO_PIN",
            "SD_MOSI_PIN",
            "SD_CS_PIN",
        ):
            self.assertIn(symbol, registry)

    def test_future_buses_stay_unassigned(self):
        import re
        # MP3_RX_PIN y MP3_TX_PIN ya no son #define separados;
        # el DFPlayer usa pins 4/7 por pin remapping en perfil 4.
        self.assertNotIn("#define MP3_RX_PIN", self.source)
        self.assertNotIn("#define MP3_TX_PIN", self.source)
        self.assertIn("transporteDFPlayer.begin(MAPA_CASA.sda, MAPA_CASA.demo,", self.source)
        self.assertIn("MP3_BUSY_PIN", self.source)
        registry = self.source.split(
            "constexpr int PINES_RESERVADOS_DOMUS[] = {", 1
        )[1].split("};", 1)[0]
        self.assertNotIn("MP3_RX_PIN", registry)

    def test_map_is_the_single_pin_source(self):
        import re
        for token in (
            "PIN_HUMEDAD", "PIN_NIVEL_AGUA", "PIN_LDR", "PIN_PIR",
            "PIN_PARO_EMERGENCIA", "PIN_MIC_OFF", "PIN_BOTON_DEMO",
            "PIN_DHT11", "I2C_SDA_PIN", "I2C_SCL_PIN", "PINES_SALIDAS",
            "PIN_SALIDA_BOMBA",
        ):
            self.assertIsNone(
                re.search(rf"^#define\s+{token}\b", self.source, re.M), token)
        mapa = self.source.split("constexpr MapaPinesCasa MAPA_CASA = {", 1)[1].split("};", 1)[0]
        for literal in ("15", "16", "17", "18"):
            self.assertIn(literal, mapa)
        self.assertIn("MAPA_CASA.sda", self.source)
        self.assertIn("MAPA_CASA.salidas[indice]", self.source)

    def test_safety_threshold_order_is_checked_at_compile_time(self):
        for expression in (
            "UMBRAL_HUMEDAD_SECA_PCT < UMBRAL_HUMEDAD_HUMEDA_PCT",
            "UMBRAL_LUZ_OSCURO_PCT < UMBRAL_LUZ_CLARO_PCT",
            "UMBRAL_TEMP_NORMAL_C < UMBRAL_TEMP_ALTA_C",
            "MEMORIA_LIBRE_CRITICA_BYTES < MEMORIA_LIBRE_RECUPERACION_BYTES",
        ):
            self.assertIn(f"static_assert({expression}", self.source)

    def test_outputs_are_preloaded_off_before_output_mode(self):
        preload = "digitalWrite(MAPA_CASA.salidas[i], nivelSalida(i, false));"
        output = "pinMode(MAPA_CASA.salidas[i], SALIDA_FISICA_CASA[i] ? OUTPUT : INPUT);"
        setup = self.source.split("void setup()", 1)[1]
        self.assertLess(setup.index(preload), setup.index(output))

    def test_silence_button_does_not_block_ir_or_safety(self):
        dispatch = self.source.split("ResultadoOrden ejecutarOrdenActuador(const OrdenActuador &orden) {", 1)[1].split("\n}", 1)[0]
        self.assertNotIn("MAPA_CASA.micOff", dispatch)
        self.assertIn("EVENTO;SILENCIO;", self.source)
        self.assertIn("ORIGEN_IR", self.source)
        self.assertIn("EVENTO;SILENCIO;", self.source)

    def test_pintest_diagnostico_y_demo_por_despachador(self):
        # PINTEST <gpio> reporta crudo/pull-up/pull-down y dictamina
        # FLOTANTE vs CONECTADO; no entra a COMANDOS_VALIDOS (diagnóstico).
        self.assertIn("bool procesarPinTest(const String &comando)", self.source)
        self.assertIn("PINTEST;GPIO=%d;CRUDO=%d;PULLUP=%d;PULLDOWN=%d", self.source)
        self.assertIn("FLOTANTE", self.source)
        # La demo pasa por el despachador (interlocks intactos), no al GPIO.
        demo = self.source.split("void demoSecuenciaActualizar() {", 1)[1].split("\n}\n", 1)[0]
        self.assertIn("ejecutarComandoRele", demo)
        self.assertNotIn("digitalWrite", demo)
        # LCD descartado (quemado): sin reintento de pantalla en el mínimo.

    def test_botones_nuevos_serial_y_tecla_ch_spare(self):
        # LCD quemado (nota 80): CH alterna Spare; Serial expone SPARE/TODO/DEMO.
        self.assertIn("case CH:", self.source)
        teclas = self.source.split("void ejecutarTeblaIRCasa", 1)
        teclas = self.source.split("void ejecutarTeclaIRCasa", 1)[1].split(
            "\n}\n", 1)[0]
        ch = teclas.split("case CH:", 1)[1].split("case CH_MAS:", 1)[0]
        self.assertIn('alternarSalidaIR(4, "SPARE", "Spare")', ch)
        self.assertNotIn("PANTALLA_SIGUIENTE", ch)
        # Mapa feria: tope usable, sin audio, 3 usable, consultas al final.
        self.assertIn("fijarModoManualIR", teclas)
        self.assertIn("fijarModoAutoIR", teclas)
        self.assertIn("parpadeoAutoActualizar", self.source)
        self.assertIn("MODOLUCES_AUTO", self.source)
        # AUTO = invernadero: transición de parpadeo y riego por crudo.
        self.assertIn("automatizarInvernadero", self.source)
        self.assertIn("DURACION_TRANSICION_AUTO_MS", self.source)
        self.assertIn("UMBRAL_RIEGO_SEC_CRUDO", self.source)
        self.assertIn("#define UMBRAL_RIEGO_SEC_CRUDO   4000", self.source)
        self.assertIn("BOMBA_ON_APAGA_LUCES", self.source)
        self.assertIn("BOMBA_DIRECTA_S8050", self.source)
        self.assertIn("GPIO_DIRECTO", self.source)
        self.assertIn("ACK;IR;LUCES_TODAS_ON", teclas)
        self.assertIn("ACK;IR;DEMO_ON", teclas)
        self.assertIn("ACK;IR;TODO_OFF", teclas)
        # Tecla 3 ya no es NACK de cultivo: alterna Spare.
        n3 = teclas.split("case N_3:", 1)[1].split("case N_4:", 1)[0]
        self.assertIn('alternarSalidaIR(4, "SPARE", "Spare")', n3)
        self.assertNotIn("SALIDA_NO_INSTALADA", teclas)
        # Consultas 6-9 solo al final, sin voz/LCD.
        n6 = teclas.split("case N_6:", 1)[1].split("default:", 1)[0]
        self.assertIn("construirReporteEstado", n6)
        self.assertNotIn("anunciarJarvis", n6)
        self.assertNotIn("pantallaFinal", n6)
        # carpetaSalida: cultivo = tecla 3, spare = tecla CH (no al revés).
        mapa = self.source.split("EventoJarvis carpetaSalida", 1)[1].split(
            "\n}", 1)[0]
        self.assertIn("case 3: return EventoJarvis::TECLA_3;", mapa)
        self.assertIn("case 4: return EventoJarvis::CH;", mapa)
        for comando in (
            '"SPARE_ON"', '"SPARE_OFF"', '"SPARE_AUTO"',
            '"TODO_ON"', '"TODO_OFF"',
            '"DEMO_ON"', '"DEMO_OFF"',
            '"MODO_MANUAL"', '"MODO_AUTO"',
            '"FALLO"',
        ):
            if comando == '"FALLO"':
                self.assertIn("EventoJarvis::FALLO", self.source)
            else:
                self.assertIn(comando, self.source)
        for removido in (
            '"LUZC_ON"', '"LUZC_OFF"', '"LUZC_AUTO"',
            '"INVER_ON"', '"INVER_OFF"', '"INVER_AUTO"',
            '"CAL_NIVEL"',
        ):
            self.assertNotIn(removido, self.source)
        self.assertIn('{"SPARE_ON", 4, 1}', self.source)
        self.assertIn('comando == "TODO_ON"', self.source)
        self.assertIn('comando == "DEMO_ON"', self.source)
        self.assertIn('comando == "MODO_AUTO"', self.source)
        self.assertIn("iniciarSecuenciaDemo();", self.source)


if __name__ == "__main__":
    unittest.main(verbosity=2)
