gvayoy-web/proyecto-domus/(commit log)

2026-09-17 feat: integra audio Jarvis con dos voces
    [MANIFEST.csv]
2026-09-17 feat: implementar automaciones combinadas, historial/estadísticas, LCD views 5&6, expansión de audio Carlos/Karla, y reorganización MP3 por proyecto DOMUS
    - Agregado verificarAutomacionesCombinadas(): calor+tierra_seca+agua, temp+presencia
    - Agregado verificarLucesCombinadas(): luz+presencia+zonas_día
    - Agregado EstadisticasDOMUS atómico con contadores: encendidos, apagados, rièges, ventiladores, cambios luz, emergencias, errores sensores
    - Agregado registrarHistorial() y emitirEventoHistorial() para logging a microSD
    - Agregado NUM_PANTALLAS=7 con views 5 (estadísticas) y 6 (perfil/configuración)
    - Agregado iniciarSecuenciaDemo()/detenerSecuenciaDemo() con patrones no bloqueantes 2s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
    [MANIFEST.csv]
2026-09-17 feat: audio 1:1 con las 21 teclas (28 eventos, 224 MP3) + optimizacion y correccion del firmware
    Audio (nota 46):
    - Catalogo ampliado 14 -> 28 eventos: cada tecla CAR MP3 tiene su carpeta
    (modos, diagnostico, todo apagado, sonido, rearme, cultivo, ventilador,
    riego, consultas 6/7/8/9). Voz 1 Carlos SD 01-28, voz 2 Karla SD 51-78.
    - 112 pistas nuevas grabadas con edge-tts (es-HN Carlos/KarlaNeural);
    MANIFEST.csv con 224 filas, frase, bytes y SHA-256.
    - Tecla 6: 1 pulsacion = consulta temperatura, doble (<2 s) = cambio de voz
    (resuelve conflicto notas 46 vs 67; 6-9 ya no repiten reporte).
    - Nota 67 vigente: PLAY = silencio, 100+ = repetir ultima pista.
    Firmware (optimizacion + bugs re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
    [MANIFEST.csv]
2026-09-17 feat: 21 eventos uno por boton (codigos nota 64, acciones nota 46)
    Audio: catalogo 28 -> 21 carpetas por boton (Carlos SD 01-21, Karla SD
    51-71, 168 MP3). Variantes con significado: conmutadores 1/2 manual y
    3/4 automatico; boton 0: 1-2 apagado, 3-4 PARO; EQ 3-4 sensor; tecla 8
    v4 deposito bajo; tecla 9 v3 'Sistemas en linea'. Carpetas 22-28/72-78
    eliminadas. MANIFEST.csv con 168 filas.
    Firmware: CH- fija modo manual y CH+ modo automatico en todas las
    salidas (nota 46); cada tecla anuncia su carpeta tras el ACK/NACK real;
    PARO usa el grupo de emergencia de su boton; arranque y cambio de voz
    usan tecla 9 v3. Codigos fisicos documentados en domus_ir_casa.h.
    Tests: audio reescrito a 21 botone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
    [MANIFEST.csv]
2026-09-17 feat: un boton una funcion + puerta ordenada del mando
    - 100+ alterna la voz de un toque (Carlos por defecto; el anuncio suena
    ya en la voz nueva, variante 1/2). Fuera la doble-pulsacion del 6:
    el 6 solo consulta temperatura. PLAY = silencio. Repetir sale del
    mando y queda en Serial (comando REPETIR).
    - Puerta ordenada: mientras Jarvis habla (BUSY) o 1.5 s tras la orden,
    el IR responde NACK;IR;OCUPADO. La saltan el aprendizaje, la tecla 0
    y el PARO fisico/Serial, que nunca se bloquean.
    - Mapa reordenado como el mando fisico: arriba configuracion, abajo
    acciones en orden (1-5 luces/bomba, 6-9 lecturas).
    - Carpeta 11 regrabada (voz Carlos/Karla); manifiesto actualizado.
    - Tests: 10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
    [MANIFEST.csv]
2026-09-17 feat: ronda v4.3 rescate + LCD + optimizacion
    Rescate (no enlazaba): registrarLineaMicroSD definida, seccion 10
    reconstruida (duplicado + funcion fantasma + return huerfano), vars
    del combinado declaradas, atomic<AutoTemporizado> a struct plano.
    Sensores: ADC 8->4 muestras, DHT con reintento 60 s (fin del latch) y
    DHT_FALLOS en DIAGNOSTICO; leerNivelAgua intacto (fijado por tests).
    LCD: vista 3 compacta 1 letra, vista 5 ENC/APA/R/V/E, vista 6 perfil
    corto, icono de nivel, avisos por tecla 2.5 s, CH sin auto-tapa,
    consultas 6-9 saltan a su vista, mute/voz en vista 6, humedad con
    rango propio.
    Voz/logica: cortes SISTEMA como automaticos, tecla 5 toggle,
    PLAY OFF por LCD, microSD 01-21/51-71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
2026-09-17 docs: diagrama de conexiones del banco explicado (MAPA_CASA perfil 3)
2026-09-17 feat: stream SENSORES; periodico + docs al dia con mapa real
    El HIL con la placa conectada revelo que test_07 esperaba telemetria
    SENSORES; que el firmware nunca emitia. Nueva seccion 13C:
    emitirTelemetriaSensores() cada 2 s con ultimos valores validos (sin
    muestrear, sin bloquear, sin SD, funciona en modo seguro) + contrato
    estatico que impide que vuelva a faltar en silencio.
    Docs: README de firmware al catalogo real (168 pistas, 01-21/51-71,
    mapa por boton, puerta OCUPADO), sesion IR con tecla 5 toggle,
    comentarios de headers alineados (100+ = voz, 6 = consulta).
2026-09-18 fix: compilar en Arduino real (enum demo, orden de globales DHT)
    [casa_inteligente_v4.ino]
2026-09-18 fix: limitar avisos de sensor a 1/30s (flood de 86k errores) + reporte sesion HIL
    [casa_inteligente_v4.ino, test_native_firmware.py]
2026-09-18 docs: corregir diagnostico LDR (pin flotante, no sensor vivo)
2026-09-18 feat: deteccion de pin flotante + comando PINTEST + reporte de medicion real
2026-09-18 docs: nota 69 restriccion lado usable + test guardian de GPIO
2026-09-21 feat: firmware v5 - eliminate ventilador, update GPIO map, fix bool bug
    - ELIMINAR verificarVentiladorCombinado, verificarVentiladorAutomatico, verificarLucesAutomaticas
    - FIX: float tempAutoValida = false → bool tempAutoValida = leerAmbiente(...)
    - DFPlayer UART reasignado de GPIO4/7 a GPIO11/18 (evita conflicto bomba/cultivo)
    - MAPA_CASA actualizado: bomba=4, casa=5, porche=8, cultivo=7, spare=8
    - Nombres salidas: Casa, Porche, Cultivo, Spare (eliminados Sala/Cuarto/Ventilador/Inv)
    - domus_drivers.h: comentado DRV8833 PIN_BIN1/BIN2 (ventilador muerto)
    - domus_ir_casa.h: N_4 renombrado de ventilador a todas_luces
    - domus_pantalla.h: LCD abbreviations actualizadas (B/Ca/P/Cu/Sp)
    - COMANDOS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
    [casa_inteligente_v4.ino, domus_drivers.h, domus_ir_casa.h, domus_pantalla.h]
2026-09-21 feat: modo inteligente, diagnostico robusto, audio en todas las teclas
    - Modo inteligente: struct EstadoInteligente + ejecutarModoInteligente()
    - Coordina riego, luces casa/porche/cultivo con limites diarios
    - Bomba: max 30 min/dia, cooldown 5 min entre ciclos
    - Cultivo: max 16h/dia fotoperiodo
    - Luces casa: ON con oscuridad+presencia, OFF sin presencia (ahorro)
    - Degradacion: DHT11 timeout 5min, interlock agua baja
    - Audio contextual para cada accion
    - Diagnostico robusto (tecla EQ): diagnosticarSensores()
    - Lee 7 sensores/hardware: DHT11, suelo, nivel, LDR, PIR, bomba, LCD
    - Muestra cada uno en LCD 2s con resultado OK/FAIL
    - Reporte final por Serial: DIAG;RESUMEN;OK=N;FA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
    [casa_inteligente_v4.ino]
2026-09-21 fix: errores criticos + guia de conexiones completa
    Correcciones de errores:
    - UMBRAL_HUMEDAD_BAJA_PCT no existia → UMBRAL_HUMEDAD_SECA_PCT (35%)
    - ultimoCicloCheckMs declarado despues de uso → movido antes
    - PIR diagnostico siempre true → lectura doble con pausa
    - Audio sin variantes ON/OFF → ahora usa variantes 1=ON, 2=OFF, 3=ON_auto, 4=OFF_auto
    - EventoJarvis: aliases semanticos agregados (CASA_ENCENDIDA, RIEGO_INICIADO, etc.)
    - Comentarios actualizados: ventilador → todas_luces
    Entregables:
    - hardware/Conexion_Domus_Guia_Completa.html: guia visual completa con diagramas
    - nota 78: Guia de Conexiones Completa v5 (Obsidian)
    - Mapa de colores de cables por GPIO
    - Checklist pre-en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
    [casa_inteligente_v4.ino, domus_jarvis_audio.h]
2026-09-21 fix: DFPlayer GPIO labels, PIR eliminado, LCD pull-ups documentados
    DFPlayer:
    - GPIO11 = ESP32 RX (recibe de DFPlayer TX)
    - GPIO18 = ESP32 TX (envia a DFPlayer RX)
    - HTML: diagrama y tabla actualizados con flechas direccionales
    PIR eliminado (no existe fisicamente):
    - Struct MapaPinesCasa: campo pir eliminado
    - MAPA_CASA: GPIO9 ya no asignado a PIR
    - verificarLucesCombinadas: presencia constante=true
    - Modo inteligente: presencia constante=true
    - Diagnostico: PIR reporta 'SIN_HW' en vez de leer GPIO
    - Telemetria: PIR= reemplazado por PRESENCIA=1
    - PRUEBA;ACCIONES: MUEVE_PIR eliminado
    - HTML: referencias PIR eliminadas
    LCD I2C:
    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
    [casa_inteligente_v4.ino]
2026-09-21 fix: corrige nombres en audio, HTML y comentario firmware
    - Actualiza CATALOGO: sala→casa, cuarto→porche, ventilador→todas_luces
    - Regenera 24 MP3 con frases correctas (carpetas 04, 06, 16 ambas voces)
    - Actualiza MANIFEST.csv con hashes nuevos
    - Corrige HTML: PIR marcado como SIN_HW en diagnostico
    - Corrige comentario carpetaSalida: ventilador→todas_luces
    [MANIFEST.csv]
2026-09-21 fix: tests y nativos alineados con firmware actual
    - native_integration.cpp: PINES_SALIDAS={4,5,8,7,8} igual a MAPA_CASA.salidas
    - test_casa_candidato: campos micOff/demo restaurados (no dfRx/dfTx)
    - test_firmware_contract: LUCES_BLOQUEADAS (no LUCES_AUTO_BLOQUEADAS_SENSOR)
    - test_pantalla_final: formatear page 3 = B:0 Ca:0 P:0 (nombres actuales)
    - Struct: commentario micOff/DFPlayer RX actualizado (field name no cambia)
    - 106 passed, 8 skipped, 0 failed
    [casa_inteligente_v4.ino, native_integration.cpp, test_casa_candidato.py, test_firmware_contract.py, test_jarvis_audio.py, test_pantalla_final.py]
2026-09-23 feat: compilacion exitosa, upload COM9, HIL alineados, nota Obsidian 79
    - Corregido GPIO duplicado: spare=8 -> GPIO6 (porche=8 liberado)
    - Eliminadas referencias DRV8833_PIN_BIN1/BIN2 (ventilador muerto)
    - Struct ResultadoDiagnostico movido antes de forward declarations Arduino
    - Firmware compilado (13% flash, 8% RAM) y subido a COM9 (ESP32-S3 N16R8)
    - Tests HIL actualizados: Luz Sala->Casa, Luz Cuarto->Porche, etc.
    - Nota Obsidian 79: sesion compilacion upload COM9 y HIL
    - Notas Obsidian 70-72: mejoras firmware, perfil DRV8833, programa TODO
    - GUIAs de conexiones, planos HTML, modelos 3D, sketches auxiliares
2026-09-24 fix: remap micOff 11->9 y DFPlayer RX 11->17 (placa sin GPIO11, LCD liberado); HIL 8/8 COM9
    [casa_inteligente_v4.ino, native_integration.cpp, test_firmware_contract.py, test_jarvis_audio.py]
2026-09-24 feat: audios evento 02 y FALLO (22/72) Carlos/Karla, ajustes firmware y tests
    [MANIFEST.csv]
2026-09-26 feat: cierre jurado — bomba GPIO17 y fix PINTEST, Jarvis PC voz/SFX/diagnostico hablado, nota 82, README y docs 107+64
    [casa_inteligente_v4.ino, domus_drivers.h, native_integration.cpp, test_casa_candidato.py, test_firmware_contract.py, test_native_firmware.py, validate_project.py]
2026-09-26 docs: README final con guia de construccion completa (planos, cableado, firmware, pruebas, Jarvis); notas 74/18/82 al dia
2026-09-26 fix: declara sobrecargas de log/emitirEventoLocal y rearmarSistema (wrapper domus_esqueleto no hereda prototipos del .ino incluido)
    [casa_inteligente_v4.ino]
2026-09-26 docs: PROXIMOS_PASOS con instrucciones de todo lo que falta (repo, CI, calibracion, SD, DFPlayer, g++); enlaces desde README e INDICE
