gvayoy-web/proyecto-domus/(notices)

Notices in the files:
README.md:
License: MIT
